laurentflorin/marax-pressure-mod/doc/README.md

# Here you will find more Details about the build

[The UI](ui/ui_overview.md)

[The Hardware](hardware/hardware.md)

[The Build](build/build.md)

[Pressure Profiles](profiles/profiles.md)

[Home Assistant Integration](homeassistant/homeassistant.md)

[Linux upload permissions for the ESP32-S3 board](build/linux-upload-permissions.md)
