laurentflorin/marax-pressure-mod/doc/ui/ui_overview.md

# A overview of the different UI pages

## Home page

The home page displays the brew and steam temperature, further the bluetooth sign shows if the Felicita Arc scale is connected.

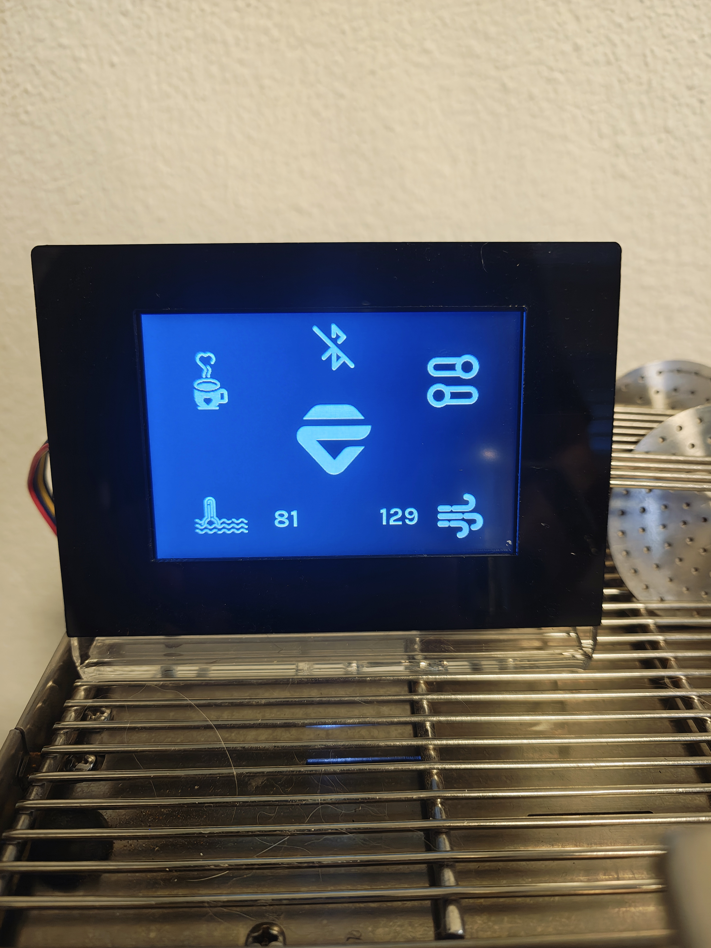
[picture p1: assets/home_scale_not_connected.jpg]
HomePage_no_scale

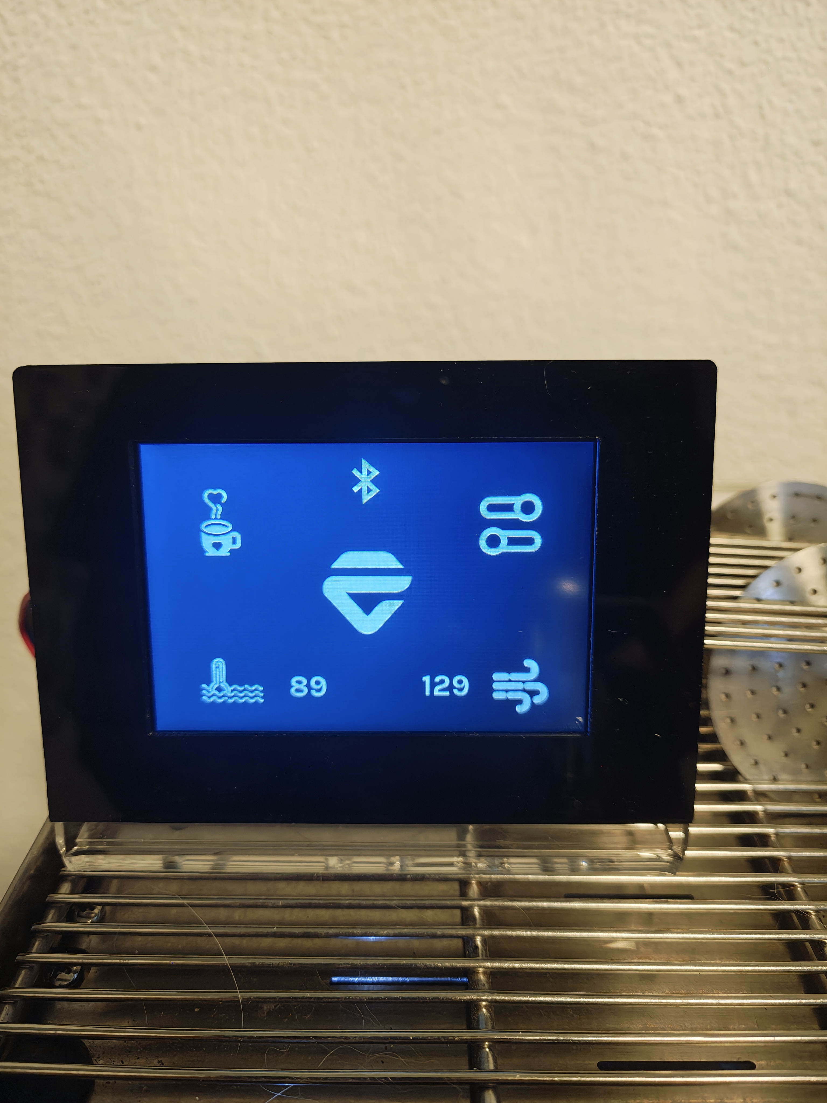
[picture p2: assets/home_scale_connected.jpg]
HomePage_scale


By touching the right top icon the settings page can be reached. By touching the coffe cup icon the brew page is opened.
## Settings Page

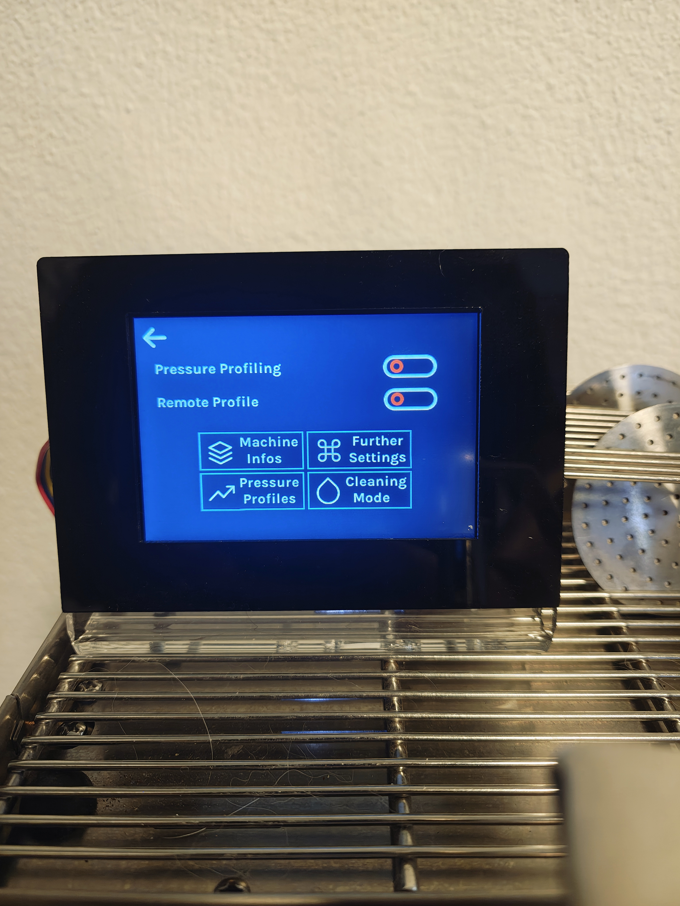
[picture p3: assets/settings.jpg]
Settings


On the settings page the other pages can be reached. As well as the pressure profiling and remote profile can be activated. For the use of preset profiles, both have to be activated.

## Brew graph page

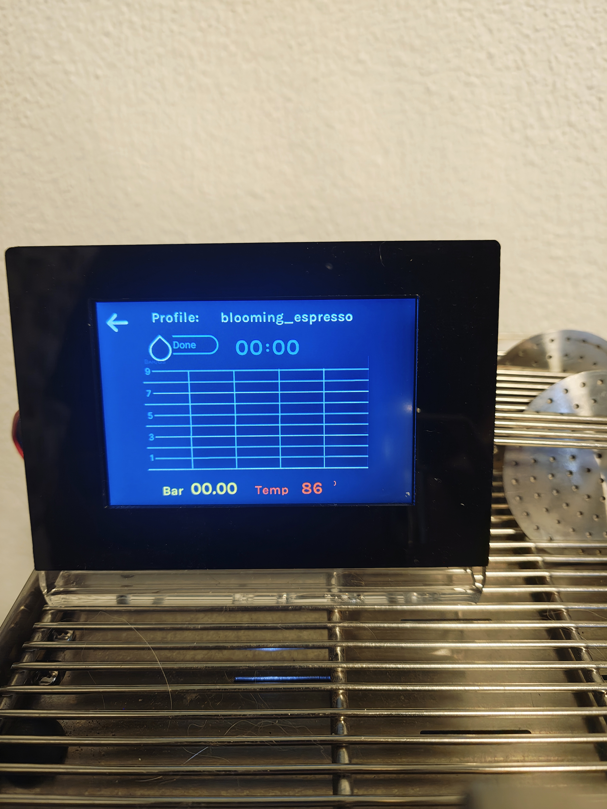
[picture p4: assets/brew_page.jpg]
BrewGraph


The brew graph page will automatically be shown if the brew leaver it switched to the "on/top" postion

## Cleaning Page

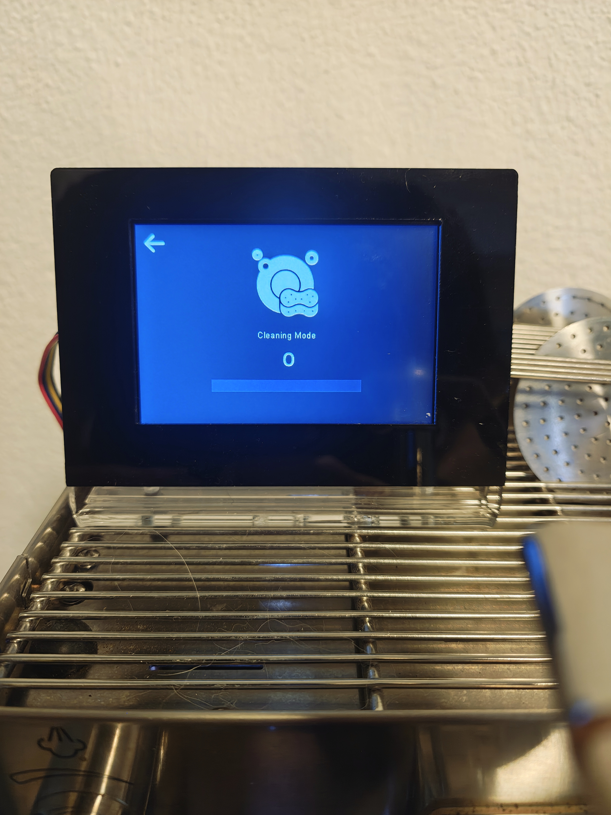
[picture p5: assets/clean_page.jpg]
CleaningPage


If the cleaning page is active, it will count the shot time of the cleaning flush as well as the current amount of flushes that have been done.

## Pressure Profile Selection Page

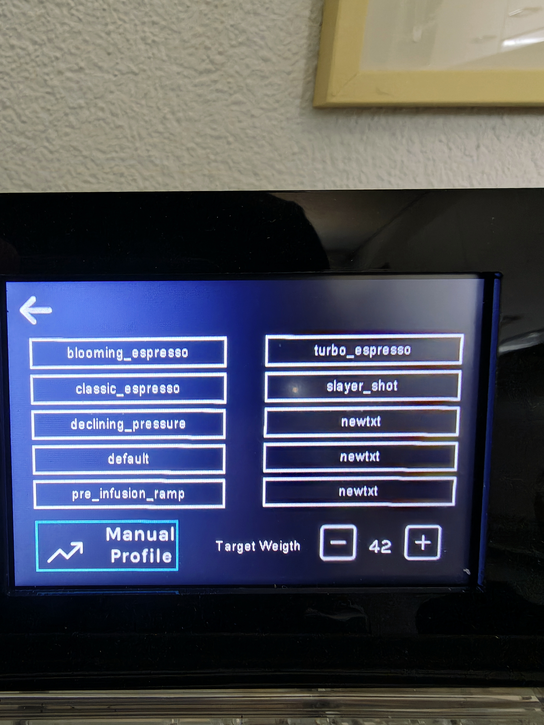
[picture p6: assets/profile_selection.jpg]
PP_Page


On this page the desired preset profile can be chosen as well as the target output weight. 

## Manual Pressure Profile Selection 

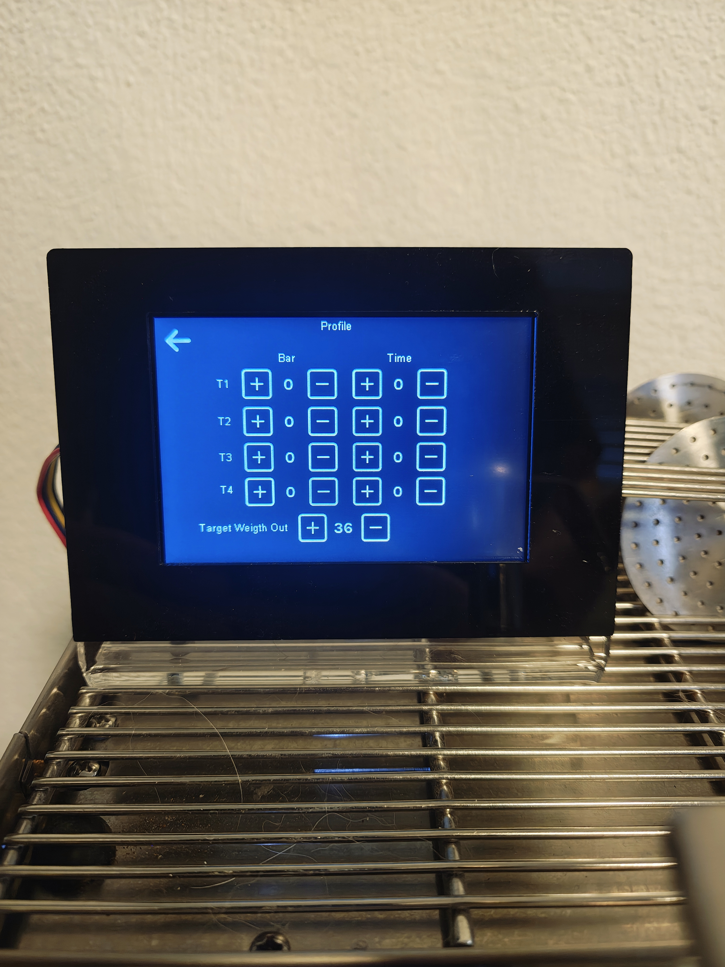
[picture p7: assets/manual_profile.jpg]
PP_Page_manual

Here a manual pressure profile can be set up. To use the manual profile Remote profile has top be switched off.
The Pressure Profile that can be set. There a four time slots which can each have different pressures set.
Example Shot -> 5 Bar for 5 Sec. then 6 Bar for 6 Sec. then 7 Bar for 5 Sec. then 8 Bar for 3 Sec.
