laurentflorin/marax-pressure-mod/doc/hardware/hardware.md

# Hardware List

| Component | Link |
| --- | --- |
| Nextion 3.5 | https://de.aliexpress.com/item/1005003457376097.html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 |
| Pressure Sensor | https://de.aliexpress.com/item/1005007148779919.html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 |
| 240V dimmer | https://de.aliexpress.com/item/32802025086.html?gatewayAdapt=glo2deu |
| Relay | https://de.aliexpress.com/item/1005010569779398.html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 |
| stand for nexiton 3.5 | https://de.aliexpress.com/item/4000024254086.html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 |
| 12V to 5V Dc Dc Stepdown converter | https://de.aliexpress.com/item/1005010036505161.html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 |
| Cable 17 AWG | https://de.aliexpress.com/item/1005011947614719.html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 |
| Cable sleeve | https://de.aliexpress.com/item/1005007570262725.html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 |
| resistor | https://de.aliexpress.com/item/1005011767578775.html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 |
| Arduino nano breakout board | https://de.aliexpress.com/item/1005008228852970.html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 |
| dupont crimping tool | https://de.aliexpress.com/item/1005009408516954.html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 |
| ptfe tube cutter | https://de.aliexpress.com/item/1005006149490949.html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 |
| Standoffs | https://de.aliexpress.com/item/32862529967.html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 |
| Crimp Connectors | https://de.aliexpress.com/item/1005009345066209.html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 |
| SD Card reader | https://www.bastelgarage.ch/micro-sd-card-reader-modul |
| Micro sd Card | https://www.bastelgarage.ch/8gb-microsdhc-memory-card-class-10-uhs-i-incl-sd-adapter?search=micro%20sd%20card |
| ESP32 S3 | [www.bastelgarage.ch/esp32-s3-dev-kit-n16r8-m-entwicklungsboard](https://www.bastelgarage.ch/esp32-s3-dev-kit-n16r8-m-entwicklungsboard) |
| g1/4 Connectors | https://www.hug-technik.com/shop/steckverschraubung-gerade-g-1-4-ig-schlauch-o-5-click-clock.html |
| T Connector | https://www.hug-technik.com/shop/t-steckverbindung-schlauch-o-5-click-clock-messing-vernickelt.html |
| Silicon Tube | https://www.bluestarcoffee.eu/en/Lelit-Ptfe-Teflon-Pipe-3x5mm/m-6151.aspx |
| AWG 24 Cables | https://www.bastelgarage.ch/kabel-16x0-25mm-awg24-grau-liyy?search=kabel |
