laurentflorin/marax-pressure-mod/assets/brew_switch_side.jpg

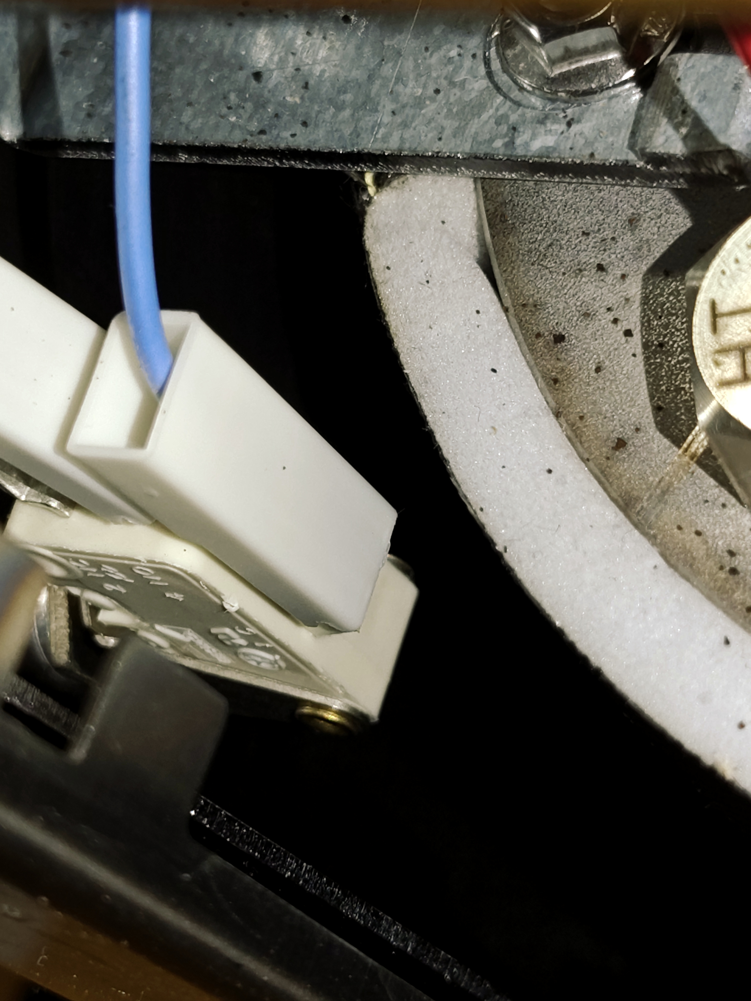
assets/brew_switch_side.jpg
