laurentflorin/marax-pressure-mod/assets/more_info.jpg

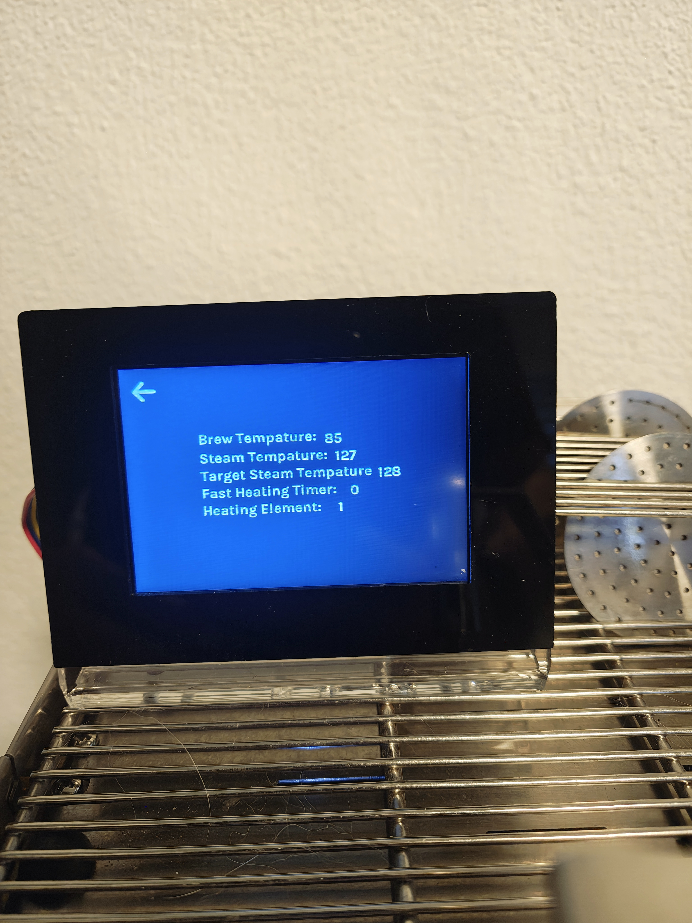
assets/more_info.jpg
