laurentflorin/marax-pressure-mod/assets/more_settings.jpg

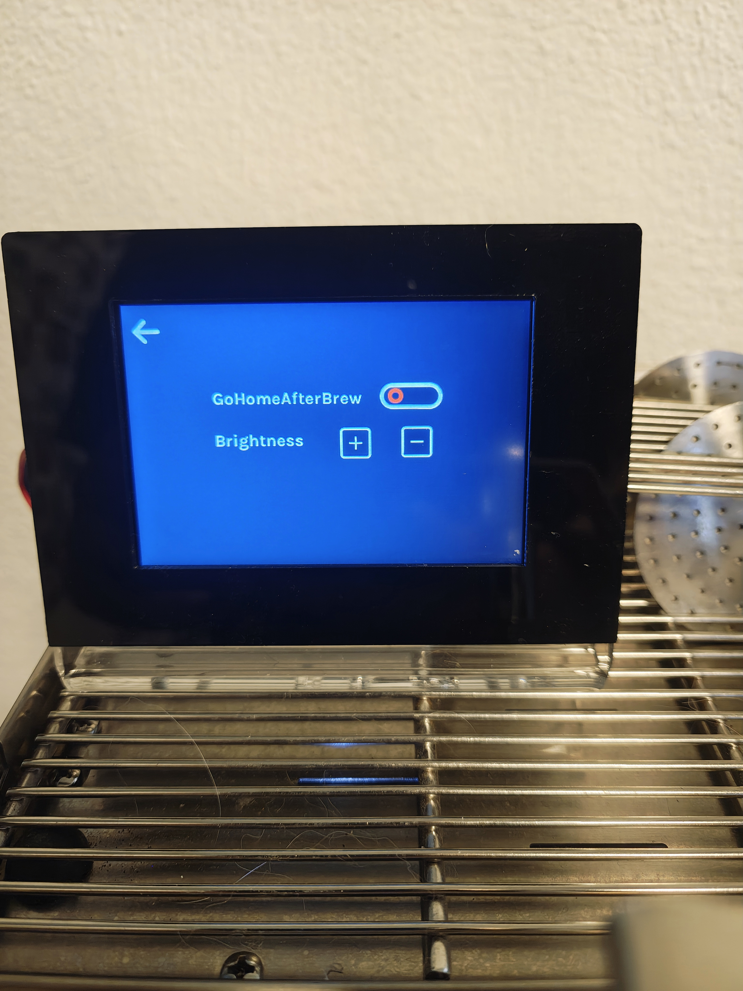
assets/more_settings.jpg
