laurentflorin/marax-pressure-mod/src/marax_esp32s3/marax_esp32s3.ino

#include <Arduino.h>
#include <EasyNextionLibrary.h>

// DISABLE WiFi to prevent radio conflicts with BLE
// ESP32-S3 has only ONE 2.4GHz radio shared between WiFi and BLE
// Disabling WiFi gives BLE full control for reliable scale connection
// #define DISABLE_WIFI_MQTT

// ─────────────────────────────────────────────────────────────────────────
// OTA (Over-The-Air firmware updates over WiFi)
// Comment out ENABLE_OTA to build without OTA.
//
// WARNING: OTA requires WiFi. The ESP32-S3 shares ONE 2.4GHz radio between
// WiFi and BLE, so bringing WiFi up for OTA can reduce BLE scale reliability
// (this is the very reason DISABLE_WIFI_MQTT exists). The OTA code here is
// non-blocking and never stalls normal operation. Set wifi_ssid /
// wifi_password (below) before using OTA.
// Flashing: Arduino IDE → Tools → Port → network port "MaraXController at <ip>".
// ─────────────────────────────────────────────────────────────────────────
#define ENABLE_OTA

#include <WiFi.h>
#include <PubSubClient.h>
#include <SD.h>
#include <SPI.h>
#include <Preferences.h>
#include <driver/uart.h>
#include <NimBLEDevice.h>
#include "FelicitaScale_NimBLE.h"

#ifdef ENABLE_OTA
#include <ESPmDNS.h>
#include <ArduinoOTA.h>
#endif

// === Required Libraries ===
// - EasyNextionLibrary     (Arduino Library Manager)
// - WiFi                   (built-in with ESP32 Arduino core)
// - PubSubClient           (Arduino Library Manager)
// - SD                     (Arduino built-in)
// - NimBLE-Arduino         (Arduino Library Manager) - REQUIRED for ESP32-S3 BLE
// NOTE: ArduinoBLE and AcaiaArduinoBLE are NOT compatible with ESP32-S3!
//       Using NimBLE-based implementation instead (FelicitaScale_NimBLE.h)
//
// Arduino IDE board: "ESP32S3 Dev Module"
//   Board package:   esp32 by Espressif Systems (Boards Manager)
//   Flash size:      16MB (128Mb)
//   PSRAM:           OPI PSRAM
//   USB Mode:        Hardware CDC and JTAG

// ═══════════════════════════════════════════════════════════════════════════
// Board: ESP32-S3-DEV-KIT-N16R8-M (Waveshare)
//
// The Mara X GiCar board outputs INVERTED UART (idle LOW, like RS-232).
// On ESP32-S3 this is fixed in SOFTWARE via uart_set_line_inverse().
// No hardware inverter or transistor required!
//
// IMPORTANT: Physical wiring - ESP32 RX connects to MaraX TX, and vice versa:
//   - ESP32 GPIO16 (RX) ← physically wire to → MaraX TX pin
//   - ESP32 GPIO17 (TX) ← physically wire to → MaraX RX pin
//
// Pin Assignments:
//   GPIO16  ← MaraX TX   (UART1 RX, inverted in software)
//   GPIO17  → MaraX RX   (UART1 TX)
//   GPIO18  ← Nextion TX (UART2 RX)
//   GPIO8   → Nextion RX (UART2 TX)
//   GPIO3   ← Pressure sensor output (ADC1_CH2)
//              IMPORTANT: Must use ADC1 (GPIO1–10). ADC2 (GPIO11–20)
//              cannot be used for analog reads when WiFi is active!
//   GPIO4   ← AC mains zero-cross detection (sync for dimmable_light)
//   GPIO5   → Pump TRIAC gate (via optocoupler)
//   GPIO6   ← Brew lever switch input
//   GPIO7   → GiCar brew relay output
//   GPIO10  → SD card CS
//   GPIO11  → SD card MOSI (SPI2 / FSPI)
//   GPIO12  → SD card SCK
//   GPIO13  ← SD card MISO
//
// Machine Data Format: CSV (field order as parsed by getMaschineInput())
//   Example frame: +1.10,103,128,077,0000,1,0
//   Field 0: Version/Mode (+1.10)
//   Field 1: Steam temperature (103 = 103°C)
//   Field 2: Steam target temperature (128 = 128°C, may be empty)
//   Field 3: Brew temperature (077 = 77°C)
//   Field 4: Fast heat countdown (0000)
//   Field 5: Heating element status (0 = off, 1 = on)
//   Field 6: Unknown
// ═══════════════════════════════════════════════════════════════════════════

#define MARAX_RX_PIN         16
#define MARAX_TX_PIN         17
#define NEXTION_RX_PIN       18
#define NEXTION_TX_PIN        8
#define PRESSURE_SENSOR_PIN   3   // ADC1_CH2 — safe to use with WiFi
#define AC_ZERO_CROSS_PIN     4
#define PUMP_PIN              5
#define BREW_SWITCH_PIN       6
#define BREW_RELAY_PIN        7
#define SD_CS_PIN            10
#define SD_MOSI_PIN          11
#define SD_SCK_PIN           12
#define SD_MISO_PIN          13

// Brew input/relay electrical behavior:
// - BREW_SWITCH_ACTIVE_LOW=1 means GPIO reads LOW when lever is ON (default).
// - BREW_RELAY_ACTIVE_HIGH=1 means GPIO HIGH energizes relay (default).
// If your relay board is low-level-trigger, set BREW_RELAY_ACTIVE_HIGH to 0.
#define BREW_SWITCH_ACTIVE_LOW 1
#define BREW_RELAY_ACTIVE_HIGH 1
#define BREW_SWITCH_DEBOUNCE_MS 35

// nunununununununununununununununununununununununununununununun
// nunununununununununununu Wifi and Bluetooth
// nunununununununununununununununununununununununununununununun
#define wifi_ssid ""
#define wifi_password ""
// Scale MAC address - empty string enables auto-discovery of any Felicita scale
#define SCALE_MAC_ADDRESS ""

WiFiClient wifiClient;
bool wifiConnected = false;
bool scaleConnected = false;

// nunununununununununununununununununununununununununununununun
// nunununununununununununu Timers
// nunununununununununununununununununununununununununununununun
long serialMaraxUpdateMillis = millis();
long updateMqttTimer = millis();
long readSettigsRefreshTimer = millis();
unsigned long pageRefreshTimer = millis();
unsigned long refresh_timer = millis();
unsigned long activeBrewingStart = millis();
unsigned long lastWifiReconnectAttemptMs = 0;
unsigned long lastMqttReconnectAttemptMs = 0;
const unsigned long WIFI_RECONNECT_INTERVAL_MS = 10000;  // Try every 10 seconds
const unsigned long MQTT_RECONNECT_INTERVAL_MS = 5000;   // Try every 5 seconds

bool POWER_ON = false;

// Nextion display on UART2 (Serial2)
// Note: we initialize Serial2 directly in setup() with explicit pins.
// myNex.begin() is intentionally NOT called — doing so would re-init Serial2
// with default pins, overriding our custom NEXTION_RX/TX pin assignment.
EasyNex myNex(Serial2);

// Forward declaration required because PubSubClient constructor references it
void callbackfun(char *topic, byte *payload, unsigned int length);
void showProfileSelection();
void populateProfileList();
void handleProfileSelection(int rowIndex);
bool selectProfile(int profileIndex);
void handleNextionProfileTouchEvents();
void loadPersistedProfileSelection();
void persistSelectedProfile();
void loadPersistedTargetWeight();
void persistTargetWeight();
void updateTargetWeightUi(bool force);
void updateProfileSelectionHighlight();
bool loadProfile(const char *filename);
void updateProfileModeText();
void scanProfiles();
bool readRawBrewSwitchOn();
bool readDebouncedBrewSwitchOn();
void writeBrewRelay(bool brewOn);
void resumeIdleBoilerFill();
void applyManualStepsToProfile();
void publishProfileState();
void processPendingProfileCommand();
void buildProfileCsv(String &out);
float profileTotalSeconds();
float profileTargetPressureAt(float second);
int pressureToWave(float bar);
void writeBrewTimerColour(uint32_t colour);
void writeSetBarValue(int wave);

// nunununununununununununununununununununununununununununununun
// nunununununununununununu MQTT Settings
// nunununununununununununununununununununununununununununununun
#define mqtt_server ""
#define mqtt_user ""
#define mqtt_password ""

#define brewtemp_topic           "marax/sensor/brewtemp"
#define steamtemp_topic          "marax/sensor/steamtemp"
#define steamtargettemp_topic    "marax/sensor/steamtargettemp"
#define fastheat_topic           "marax/sensor/fastheat_timer"
#define heatingElement_topic     "marax/sensor/heatingelement"
#define debug_topic              "marax/sensor/debug"
#define shots_topic              "marax/sensor/shots"
#define power_topic              "marax/sensor/power_state"

// Last-will topic: retained "online" while the ESP32 is connected, flipped to
// "offline" by the broker the moment the connection drops. Every discovered
// entity references it, so Home Assistant greys them out instead of showing a
// stale retained reading when the controller is unplugged or loses WiFi.
#define availability_topic       "marax/status"

// Profile editing. The controller publishes the profile list, the active
// profile's name and its full body; commands arrive on the select/save/delete
// topics and every one of them is answered on the result topic.
//
// The body is the same v2 CSV that lives on the SD card, in both directions.
// Carrying one format end to end means the firmware never has to parse JSON:
// it validates the bytes with the reader it already has and writes them
// straight to the card.
#define profile_list_topic       "marax/profile/list"
#define profile_name_topic       "marax/profile/name"
#define profile_active_topic     "marax/profile/active"
#define profile_result_topic     "marax/profile/result"
#define profile_select_topic     "marax/profile/select"
#define profile_save_prefix      "marax/profile/save/"
#define profile_delete_prefix    "marax/profile/delete/"

// ─────────────────────────────────────────────────────────────────────────
// Home Assistant MQTT discovery
//
// With this enabled the controller publishes retained config payloads under
// homeassistant/<component>/marax/<id>/config on every MQTT (re)connect, and
// Home Assistant creates the entities itself — no YAML needed on the HA side.
// Comment out to keep publishing plain values without announcing them.
// ─────────────────────────────────────────────────────────────────────────
#define ENABLE_HA_DISCOVERY

#define ha_discovery_prefix      "homeassistant"
#define ha_device_id             "marax"

// PubSubClient's default 256-byte buffer would silently drop every payload
// bigger than that (publish() just returns false). The largest traffic here is
// a full profile body and the profile-select discovery payload, which carries
// one option per profile on the card.
#define MQTT_BUFFER_SIZE         2048
// Profile bodies are bounded so an oversized retained payload cannot be
// accepted and then fail to fit in the buffer on the way back out.
#define PROFILE_BODY_MAX_LEN     1024
// The select entity announces the profiles as options. Beyond this the payload
// would not fit the buffer, so the list is cut and the truncation logged
// rather than losing the whole announcement.
#define PROFILE_SELECT_MAX_OPTIONS 40

PubSubClient mqttClient(mqtt_server, 1883, callbackfun, wifiClient);

// nunununununununununununununununununununununununununununununun
// nunununununununununununu CONSTS
// nunununununununununununununununununununununununununununununun
#define REFRESH_SCREEN_EVERY 150 // Screen refresh interval (ms)
// Nextion writes during a brew are throttled to this interval so UART2 traffic
// cannot pace the loop that runs pressure control and the weight cut-off.
#define LIVE_DATA_REFRESH_MS 100

bool brewActive = false;
bool brewTimerActive = false; // active if brewing or descaling

// nunununununununununununununununununununununununununununununun
// nunununununununununununu MaraxSerialStuff
// nunununununununununununununununununununununununununununununun
const byte numCharsSerialMarax = 32;
char receivedCharsFromMarax[numCharsSerialMarax];
static byte ndx = 0;
char endMarker = '\r'; // Mara X terminates frames with CR (\r), not LF (\n)
char rc;

// Serial Marax Sensors
int brewTemp = 0;
int steamTemp = 0;
int steamTargetTemp = 0;
int maraxMode = 0;
int fastHeatingCountDown = 0;
bool heatingElementOn = false;

// nunununununununununununununununununununununununununununununun
// nunununununununununununu Pins
// nunununununununununununununununununununununununununununununun
int brewSwitchRelayPin = BREW_RELAY_PIN;
int brewSwitchPin = BREW_SWITCH_PIN;

int shotCount = 0;

float voltage;
uint32_t barGraphValue;

bool pressureProfilingEnabled = false;
bool remoteProfilingEnabled = false;

bool cleaningModeActive = 0;
bool cleaningRunActive = 0;
int cleaningShots = 0;
int cleaningShotsWater = 0;

bool brewSwitchStableOn = false;
bool brewSwitchLastRawOn = false;
bool brewSwitchDebounceInitialized = false;
unsigned long brewSwitchLastChangeMs = 0;

uint32_t currentPageId = 0;
uint32_t lastPageId = 0;
bool displayIsInSleep = true;

// nunununununununununununununununununununununununununununununun
// nunununununununununununu Pressure Profile
// nunununununununununununununununununununununununununununununun
// A profile is a polyline. Each point anchors a target pressure at an absolute
// time from the start of the shot, and `jump` says how the curve reaches that
// point:
//
//   ramp — interpolate linearly from the previous point
//   jump — hold the previous pressure until this point's time, then step to it
//
// Together they express everything from a classic four-step staircase (every
// point a jump) to a smooth declining curve (every point a ramp), including
// mixtures: hold 3 bar, jump straight to 8, hold, then ramp down to 6.
#define MAX_PROFILE_POINTS 16
#define PROFILE_MAX_BAR 12.0f
#define PROFILE_MAX_SECONDS 600.0f
// Two points is the minimum that describes a span of time; one point has no
// duration and would leave the pump with nothing to follow.
#define PROFILE_MIN_POINTS 2

struct ProfilePoint
{
  float seconds;  // absolute time from the start of the shot
  float bar;      // target pressure at that moment
  bool jump;      // true: step at `seconds`, false: ramp in from the point before
};

ProfilePoint profilePoints[MAX_PROFILE_POINTS];
int profilePointCount = 0;

// Parsed from the profile file and preserved when it is written back, but
// deliberately NOT applied to the running `targetWeight` — the brew-by-weight
// target comes from the display and Preferences, and always has. Keeping the
// field intact means hand-edited files do not lose it on a round trip.
float profileTargetWeightField = 0.0f;

// Manual mode only: the display's four fixed step fields. The Nextion firmware
// has physical t1p…t4t inputs, so manual editing stays four steps; they are
// converted into profilePoints[] by applyManualStepsToProfile().
int t1p = 0, t1t = 0, t2p = 0, t2t = 0, t3p = 0, t3t = 0, t4p = 0, t4t = 0;

// SD / Profile globals
#define MAX_PROFILES 64
#define PROFILE_NAME_MAX_LEN 32
#define MAX_PATH_LEN 64
#define PROFILE_FIELD_COUNT 10
#define PROFILE_CSV_BUFFER_LEN 128
#define PROFILE_ROWS_PER_PAGE 10
#define PROFILE_TOUCH_COMPONENT_ID_MIN 5
#define PROFILE_TOUCH_COMPONENT_ID_MAX 14
// Fallback page ID for `profile1` (matches page order in MaraxDisplayFile.HMI).
#define PROFILE_PAGE_ID_FALLBACK 4
// How long readNextionNumber() waits for a `get` reply before giving up. The
// display answers in well under a millisecond at 115200 baud, so this is
// generous; it only elapses when the display is busy, unplugged, or asked for
// something that does not exist. Keep it well below the display refresh
// interval so a dead read cannot stall the loop.
#define NEXTION_READ_TIMEOUT_MS 150
// Depth of the touch-event queue drained by handleNextionProfileTouchEvents().
#define NEXTION_TOUCH_QUEUE_LEN 8
// Row colours on the profile selection page (RGB565).
#define PROFILE_ROW_PCO          65535  // white text
#define PROFILE_ROW_BCO           8518  // dark slate background
#define PROFILE_ROW_PCO_SELECTED  2016  // green text
#define PROFILE_ROW_BCO_SELECTED 17036  // lighter slate background
// Brew page graph, as defined in display/MaraxDisplayFile.HMI: the waveform
// `s0` has object id 1, is 350 x 180 px with dis=100, and has two channels —
// channel 0 carries the measured pressure, channel 1 the target. One sample
// per x pixel, value 0..180 spanning 0..10 bar.
#define BREW_PAGE_ID 2
#define BREW_WAVEFORM_ID 1
#define BREW_WAVEFORM_TARGET_CHANNEL 1
#define BREW_WAVEFORM_WIDTH 350
#define BREW_WAVEFORM_HEIGHT 180
// Handshake timeouts for `addt` (transparent data mode): the display answers
// 0xFE when it is ready for the raw bytes and 0xFD once it has taken them all.
#define NEXTION_ADDT_READY_TIMEOUT_MS 200
#define NEXTION_ADDT_DONE_TIMEOUT_MS 500
// Bounds for manual-mode values read back from the display. Anything outside
// these ranges is a garbled read.
#define MANUAL_PRESSURE_MAX_BAR 12
#define MANUAL_SEGMENT_MAX_SECONDS 600
#define WEIGHT_STABLE_WINDOW_MS 2000  // how long weight must be stable before committing observation
#define WEIGHT_STABLE_THRESHOLD 0.5f  // max increase (g) over stability window
#define OBSERVATION_MAX_WAIT_MS 5000 // max time to wait for stability after brew stop
char activeProfileName[PROFILE_NAME_MAX_LEN] = "default";
char activeProfileFileStem[PROFILE_NAME_MAX_LEN] = "default";
char profileNames[MAX_PROFILES][PROFILE_NAME_MAX_LEN];
int profileCount = 0;
String profileListStr = "";
int selectedProfileIndex = 0;
int profileListPageStart = 0;
int profileSelectionPageId = PROFILE_PAGE_ID_FALLBACK;
bool profilePageNeedsPopulate = true;
// Set when the brew page's target-curve preview has to be (re)drawn: on
// entering the page, and when the loaded profile changes while it is open.
bool brewPreviewNeedsDraw = false;
uint32_t lastPreviewSignature = 0;
unsigned long lastProfileScanMs = 0;
const unsigned long PROFILE_SCAN_INTERVAL_MS = 30000;
float targetWeight = 36.0f;
bool sdReady = false;
char persistedProfileFile[PROFILE_NAME_MAX_LEN] = "";
Preferences preferences;

// Kept here rather than up with the other MQTT globals because the struct
// sizes its members with PROFILE_NAME_MAX_LEN, defined just above.
// MQTT commands are recorded by the callback and carried out later from the
// main loop. The callback runs inside mqttClient.loop(); writing to the SD card
// or publishing from in there would re-enter the client and stall the loop at
// an arbitrary moment — including in the middle of a shot.
enum ProfileCommandKind
{
  PROFILE_CMD_NONE = 0,
  PROFILE_CMD_SELECT,
  PROFILE_CMD_SAVE,
  PROFILE_CMD_DELETE,
  PROFILE_CMD_TOO_LARGE  // recorded so the sender gets an answer either way
};

struct PendingProfileCommand
{
  ProfileCommandKind kind;
  char stem[PROFILE_NAME_MAX_LEN];
  char body[PROFILE_BODY_MAX_LEN];
  unsigned int bodyLength;
};

PendingProfileCommand pendingProfileCommand = { PROFILE_CMD_NONE, "", "", 0 };
// Set whenever the profile list or the active profile changes, so the retained
// topics are refreshed from the main loop rather than from wherever the change
// happened to occur.
bool profileStateDirty = true;

// Touch events arriving on UART2 are queued by nextionProcessRx() instead of
// being acted on where they are parsed, so a `get` reply can never swallow one.
struct NextionTouchEvent
{
  uint8_t pageId;
  uint8_t componentId;
  uint8_t eventType;
};
NextionTouchEvent nextionTouchQueue[NEXTION_TOUCH_QUEUE_LEN];
uint8_t nextionTouchQueueHead = 0;
uint8_t nextionTouchQueueCount = 0;

FelicitaScale_NimBLE scale(false);  // true = enable debug to see BLE scan results
float currentWeight = 0.0f;
float prevWeight = 0.0f;
unsigned long lastWeightTime = 0;
float flowRate = 0.0f;
int lastScaleConnectedUi = -1; // -1 forces first UI update
unsigned long lastScaleReconnectAttemptMs = 0;
const unsigned long SCALE_RECONNECT_INTERVAL_MS = 30000;  // 30 seconds between scan attempts

bool pendingObservation = false;
unsigned long pendingObsTime = 0;
float pendingFlowAtStop = 0.0f;
float pendingPressAtStop = 0.0f;
float pendingWeightAtStop = 0.0f;
float pendingStabilityCheckWeight = 0.0f;
unsigned long pendingStabilityCheckTime = 0;
int pendingBrewTimeS = 0;

// nunununununununununununununununununununununununununununununun
// nunununununununununununu LowPassFilterStuff
// nunununununununununununununununununununununununununununununun
const float alpha = 0.97; // Low Pass Filter alpha (0 - 1)
float filteredVal = 2048.0; // midpoint of 12-bit ADC (0–4095)
float sensorVal;

// nunununununununununununununununununununununununununununununun
// nunununununununununununu AC Dimming (Zero-Cross Phase Control)
// nunununununununununununununununununununununununununununununun
//
// NOTE: No dedicated AC dimmer library is used here because the available
// libraries (RBDdimmer, dimmable-light-arduino) conflict with ESP32-S3's
// hardware timer API changes in Arduino core v3.x.  The hand-rolled
// zero-cross + one-shot timer approach below is equivalent and confirmed
// to compile on ESP32-S3 core 3.x.
//
// How it works:
//   1. zeroCrossISR fires on every AC zero-crossing (100 times/sec at 50 Hz).
//   2. It starts a one-shot hardware timer whose period is calculated from
//      pumpBrightness: high brightness → short delay → TRIAC fires early in
//      the half-cycle → more power delivered.
//   3. triacTriggerISR fires when the timer expires and pulses the TRIAC gate.
//
// Brightness mapping (pumpBrightness 0–255):
//   0   → pump OFF  (ISR returns immediately, no TRIAC trigger)
//   255 → FULL power (TRIAC triggered immediately at zero-cross)
//   1–254 → delay = map(brightness, 0, 255, 10000µs, 100µs)
//            i.e. brightness=128 → ~5050µs delay → ~50% power
//
// Idle pressure threshold above which the boiler is considered full.
// It switches dynamically: 5.0 bar when steam is hot (>80°C), otherwise 0.5 bar.
float boilerFullPressureBar = 0.5f;

// Dimmer debug counters (global so brewDetect can seed them at brew start)
unsigned long lastDimmerDebugMs = 0;
uint32_t lastZeroCrossCountDebug = 0;
// Latch: once pressure cuts the pump in idle, stay off until next brew ends
bool boilerFullLatch = false;
// Latch: once the weight reaches target minus the pressure-dependent offset
// during a profiled brew, keep the pump off until the brew ends (lever released)
bool targetWeightReached = false;
volatile uint8_t  pumpBrightness = 255;  // 0-255, 255 = full power (no dimming)
volatile uint32_t zeroCrossCount = 0;    // Incremented in ISR, read in debug
hw_timer_t *acTimer = NULL;
portMUX_TYPE acTimerMux = portMUX_INITIALIZER_UNLOCKED;

void IRAM_ATTR zeroCrossISR() {
  zeroCrossCount++;  // Count every half-cycle (debug: expect 100/s at 50 Hz)

  // Zero-cross detected — start timer for TRIAC trigger delay
  if (pumpBrightness == 0) {
    return;  // Off, don't trigger
  }
  
  if (pumpBrightness == 255) {
    // Full power - trigger immediately with a pulse
    digitalWrite(PUMP_PIN, HIGH);
    delayMicroseconds(100);  // 100µs gate pulse — matches triacTriggerISR
    digitalWrite(PUMP_PIN, LOW);
    return;
  }
  
  // Calculate delay: 0 = ~10ms (full), 255 = ~0μs (off for AC dimming logic)
  // Switzerland: 50Hz AC mains → half-cycle = 10000μs
  uint32_t delayUs = map(pumpBrightness, 0, 255, 10000, 100);
  
  portENTER_CRITICAL_ISR(&acTimerMux);
  timerRestart(acTimer);
  timerAlarm(acTimer, delayUs, false, 0);  // One-shot timer
  portEXIT_CRITICAL_ISR(&acTimerMux);
}

void IRAM_ATTR triacTriggerISR() {
  digitalWrite(PUMP_PIN, HIGH);  // Trigger TRIAC
  delayMicroseconds(100);        // 100µs pulse — minimum for reliable MOC3021/BT136 triggering
  digitalWrite(PUMP_PIN, LOW);
}

void setPumpBrightness(uint8_t brightness) {
  portENTER_CRITICAL(&acTimerMux);
  uint8_t prev = pumpBrightness;
  pumpBrightness = brightness;
  portEXIT_CRITICAL(&acTimerMux);

  // Log every change so we can trace what is sent to the dimmer
  if (brightness != prev) {
    uint32_t delayUs = 0;
    if (brightness > 0 && brightness < 255)
      delayUs = map(brightness, 0, 255, 10000, 100);

    Serial.print("[DIMMER] ");
    Serial.print(prev); Serial.print(" → "); Serial.print(brightness);
    Serial.print("/255  (");
    Serial.print(brightness * 100 / 255);
    Serial.print("%)");
    if (brightness == 0)        Serial.print("  → PUMP OFF (no TRIAC trigger)");
    else if (brightness == 255) Serial.print("  → FULL POWER (immediate trigger)");
    else { Serial.print("  → TRIAC delay "); Serial.print(delayUs); Serial.print("µs"); }
    Serial.println();
  }
}

void resumeIdleBoilerFill()
{
  boilerFullLatch = false;
  setPumpBrightness(255);
}

void primePressureFilter()
{
  sensorVal = (float)analogRead(PRESSURE_SENSOR_PIN);
  filteredVal = sensorVal;
  voltage = (filteredVal / 4096.0f) * 3.3f;
}

// nunununununununununununununununununununununununununununununun
// nunununununununununununu OTA (Over-The-Air Updates)
// nunununununununununununununununununununununununununununununun
#ifdef ENABLE_OTA
// OTA needs WiFi. In this build WiFi may otherwise be disabled for BLE, so the
// helpers below bring WiFi up themselves (non-blocking) and start the OTA
// service lazily once an IP is obtained. Normal operation never blocks on OTA.
bool otaInitialized = false;
unsigned long lastOtaWifiAttemptMs = 0;
const unsigned long OTA_WIFI_RETRY_INTERVAL_MS = 10000;  // background reconnect cadence

void setupOTA()
{
#ifdef DISABLE_WIFI_MQTT
  // WiFi is not started anywhere else in this build — OTA must bring it up.
  WiFi.mode(WIFI_STA);
  WiFi.setHostname("MaraXController");
  WiFi.begin(wifi_ssid, wifi_password);
  lastOtaWifiAttemptMs = millis();
#endif

  ArduinoOTA.setHostname("MaraXController");
  // Optional: require a password to push updates (recommended on shared networks).
  // ArduinoOTA.setPassword("admin");

  ArduinoOTA
    .onStart([]() {
      // Safety: kill the pump before the device reboots into new firmware.
      setPumpBrightness(0);
      String type = (ArduinoOTA.getCommand() == U_FLASH) ? "sketch" : "filesystem";
      Serial.println("[OTA] Start updating " + type);
    })
    .onEnd([]() {
      Serial.println("\n[OTA] End");
    })
    .onProgress([](unsigned int progress, unsigned int total) {
      static unsigned long lastOtaProgressMs = 0;
      if (total > 0 && millis() - lastOtaProgressMs > 500) {
        Serial.printf("[OTA] Progress: %u%%\n", (progress / (total / 100)));
        lastOtaProgressMs = millis();
      }
    })
    .onError([](ota_error_t error) {
      Serial.printf("[OTA] Error[%u]: ", error);
      if (error == OTA_AUTH_ERROR)         Serial.println("Auth Failed");
      else if (error == OTA_BEGIN_ERROR)   Serial.println("Begin Failed");
      else if (error == OTA_CONNECT_ERROR) Serial.println("Connect Failed");
      else if (error == OTA_RECEIVE_ERROR) Serial.println("Receive Failed");
      else if (error == OTA_END_ERROR)     Serial.println("End Failed");
    });

  Serial.println("[OTA] Configured — waiting for WiFi to start the service");
}

void handleOTA()
{
  if (WiFi.status() == WL_CONNECTED)
  {
    if (!otaInitialized)
    {
      ArduinoOTA.begin();
      otaInitialized = true;
      Serial.print("[OTA] Ready — hostname MaraXController, IP: ");
      Serial.println(WiFi.localIP());
    }
    ArduinoOTA.handle();
  }
  else
  {
    otaInitialized = false;  // re-announce the service after a reconnect
#ifdef DISABLE_WIFI_MQTT
    // Only OTA manages WiFi in this build, so retry the connection here.
    // (When MQTT is enabled, tryReconnectWifi() owns reconnection instead.)
    unsigned long now = millis();
    if (now - lastOtaWifiAttemptMs >= OTA_WIFI_RETRY_INTERVAL_MS)
    {
      lastOtaWifiAttemptMs = now;
      WiFi.begin(wifi_ssid, wifi_password);
    }
#endif
  }
}
#endif  // ENABLE_OTA

// nunununununununununununununununununununununununununununununun
// nunununununununununununu Setup
// nunununununununununununununununununununununununununununununun
void setup()
{
  // Force the GiCar brew input inactive as soon as the sketch starts.
  // Preloading the output level before switching to OUTPUT avoids a boot
  // pulse while the pin changes modes.
  writeBrewRelay(false);
  pinMode(BREW_RELAY_PIN, OUTPUT);
  writeBrewRelay(false);

  // USB Serial for debugging — open Serial Monitor at 9600
  Serial.begin(9600);
  delay(1000);
  Serial.println("[DEBUG] setup() start");

  // ESP32-S3 ADC is 12-bit (0–4095). Must set this before any analogRead().
  analogReadResolution(12);
  primePressureFilter();

  // AC Dimming: Zero-cross interrupt and TRIAC control
  pinMode(PUMP_PIN, OUTPUT);
  digitalWrite(PUMP_PIN, LOW);
  pinMode(AC_ZERO_CROSS_PIN, INPUT);
  
  // Timer for TRIAC trigger delay
  acTimer = timerBegin(1000000);  // 1MHz (1μs resolution)
  timerAttachInterrupt(acTimer, &triacTriggerISR);
  
  // Zero-cross interrupt — try CHANGE if RISING gives ~75 ZC/s instead of ~100
  attachInterrupt(digitalPinToInterrupt(AC_ZERO_CROSS_PIN), zeroCrossISR, CHANGE);
  
  // Match the post-brew refill behavior on cold boot: give the GiCar full
  // pump authority until idle pressure says the boiler is full.
  resumeIdleBoilerFill();

  pinMode(BREW_SWITCH_PIN, INPUT_PULLUP);

  // Prime lever debounce with current hardware level so first brew transition
  // is edge-driven and not sensitive to switch contact bounce at startup.
  brewSwitchStableOn = readRawBrewSwitchOn();
  brewSwitchLastRawOn = brewSwitchStableOn;
  brewSwitchDebounceInitialized = true;
  brewSwitchLastChangeMs = millis();
  Serial.print("[BREW] Switch polarity: ");
  Serial.println(BREW_SWITCH_ACTIVE_LOW ? "LOW=ON" : "HIGH=ON");
  Serial.print("[BREW] Relay polarity: ");
  Serial.println(BREW_RELAY_ACTIVE_HIGH ? "HIGH=ON" : "LOW=ON");

  // Initialize SPI bus with custom pins for the SD card
  SPI.begin(SD_SCK_PIN, SD_MISO_PIN, SD_MOSI_PIN, SD_CS_PIN);

  delay(200);

  // ═══════════════════════════════════════════════════════════════════════════
  // MaraX UART: 9600 baud, software RX inversion.
  // uart_set_line_inverse() tells the ESP32-S3 hardware UART to treat the
  // idle-LOW (inverted) signal from the GiCar board as normal UART.
  // Must be called AFTER Serial1.begin().
  // ═══════════════════════════════════════════════════════════════════════════
  Serial1.begin(9600, SERIAL_8N1, MARAX_RX_PIN, MARAX_TX_PIN);
  Serial.print("[DEBUG] Serial1 init - RX:GPIO"); Serial.print(MARAX_RX_PIN);
  Serial.print(" TX:GPIO"); Serial.println(MARAX_TX_PIN);
  
  uart_set_line_inverse(UART_NUM_1, UART_SIGNAL_RXD_INV);
  Serial.println("[DEBUG] UART RX inversion enabled");
  
  // Test if UART can read anything
  delay(100);
  int availBytes = Serial1.available();
  Serial.print("[DEBUG] Initial Serial1.available(): "); Serial.println(availBytes);

  // Nextion display on UART2 with explicit pin assignment.
  // The HMI file shipped in this repo is configured for 115200 baud, so
  // UART2 must use the same rate here or the display will ignore writes.
  // We initialize Serial2 directly instead of calling myNex.begin(),
  // because myNex.begin() would call Serial2.begin(baud) without pin
  // arguments and overwrite our custom pin assignment.
  // The default 256-byte RX buffer overflows when the display sends a burst
  // (touch events plus `get` replies) while the loop is busy with SD or BLE
  // work, and a truncated packet desynchronises the parser.
  Serial2.setRxBufferSize(1024);
  Serial2.begin(115200, SERIAL_8N1, NEXTION_RX_PIN, NEXTION_TX_PIN);
  Serial.println("[DEBUG] Serial2 (Nextion) started at 115200");

  // Nextion's default bkcmd=2 returns a 4-byte error packet for every command
  // that fails — which includes every write to a component that is not on the
  // page currently loaded, something updateDisplay() does on each refresh.
  // That junk used to pile up in front of the 0x65 touch events. bkcmd=0
  // silences it; data returns (0x70/0x71 for `get`) are not affected.
  sendNextionCommand("bkcmd=0");

  // Force a known value onto the display right now to verify display wiring
  Serial.println("[DEBUG] Testing Nextion display - writing BOOT to t0.txt");
  myNex.writeStr("t0.txt", "BOOT");
  delay(100);
  
  // Check if display responds by reading connect message
  while (Serial2.available())
  {
    Serial.print("[DEBUG] Nextion response: 0x");
    Serial.println(Serial2.read(), HEX);
  }
  
  delay(2000);

  // Re-send bkcmd: the display shares the power rail with the ESP32, so the
  // first attempt above may have been sent before it finished booting.
  sendNextionCommand("bkcmd=0");

  Serial1.write(0x11);
  Serial.println("[DEBUG] Sent 0x11 wakeup to machine");

  preferences.begin("marax", false);
  loadPersistedProfileSelection();
  loadPersistedTargetWeight();

  // Serial Marax
  memset(receivedCharsFromMarax, 0, numCharsSerialMarax);

  // IMPORTANT: Initialize BLE scale BEFORE WiFi to avoid conflicts
  // BLE and WiFi share radio resources on ESP32, init BLE first
  Serial.println("[DEBUG] Initializing BLE hardware (NimBLE)...");
  
  if (strlen(SCALE_MAC_ADDRESS) > 0)
  {
    Serial.print("[DEBUG] Connecting to scale MAC: ");
    Serial.println(SCALE_MAC_ADDRESS);
  }
  else
  {
    Serial.println("[DEBUG] Auto-discovering any Felicita/Acaia scale...");
  }
  
  // Start scale discovery BEFORE WiFi so BLE gets the best radio conditions,
  // but keep the scan in the background so brew handling is never blocked.
  scale.beginConnect(SCALE_MAC_ADDRESS);
  scaleConnected = scale.isConnected();
  Serial.println(scaleConnected ? "[DEBUG] Scale connected" : "[DEBUG] Scale scan started in background");
  updateScaleConnectionUi();
  lastScaleReconnectAttemptMs = millis();

#ifndef DISABLE_WIFI_MQTT
  if (!mqttClient.setBufferSize(MQTT_BUFFER_SIZE))
  {
    Serial.println("[MQTT] setBufferSize failed — discovery payloads will not fit");
  }

  // WiFi — non-blocking, continue even if connection fails
  Serial.println("[DEBUG] Starting WiFi...");
  WiFi.setHostname("MaraXController");
  WiFi.begin(wifi_ssid, wifi_password);
  unsigned long wifiStartTime = millis();
  while (WiFi.status() != WL_CONNECTED && (millis() - wifiStartTime < 10000))
  {
    delay(500);
  }
  wifiConnected = (WiFi.status() == WL_CONNECTED);
  if (wifiConnected)
  {
    Serial.print("[DEBUG] WiFi connected - IP: ");
    Serial.println(WiFi.localIP());
  }
  else
  {
    Serial.println("[DEBUG] WiFi connection failed");
  }
  lastWifiReconnectAttemptMs = millis();
#else
  Serial.println("[DEBUG] WiFi/MQTT disabled for testing");
#endif

#ifdef ENABLE_OTA
  setupOTA();
#endif

  // SD card init
  Serial.print("[SD] Mounting SD card on CS=GPIO"); Serial.println(SD_CS_PIN);
  if (SD.begin(SD_CS_PIN))
  {
    sdReady = true;
    Serial.print("[SD] Mounted OK — card type: "); Serial.print(SD.cardType());
    Serial.print("  size: "); Serial.print(SD.totalBytes() / (1024 * 1024)); Serial.println(" MB");

    if (!SD.exists("/profiles"))
      SD.mkdir("/profiles");
    if (!SD.exists("/logs"))
      SD.mkdir("/logs");

    if (!SD.exists("/logs/brews.csv"))
    {
      File f = SD.open("/logs/brews.csv", FILE_WRITE);
      if (f)
      {
        f.println("timestamp_ms,profile,actual_weight,target_weight,brew_time_s,flow_rate_at_stop,pressure_at_stop,extra_weight");
        f.close();
      }
    }

    scanProfiles();
    lastProfileScanMs = millis();

    if (profileCount > 0)
    {
      int startupIndex = 0;
      if (persistedProfileFile[0] != '\0')
      {
        for (int i = 0; i < profileCount; i++)
        {
          if (strcmp(profileNames[i], persistedProfileFile) == 0)
          {
            startupIndex = i;
            break;
          }
        }
      }
      selectProfile(startupIndex);
    }

    pressureProfilingEnabled = true;
    remoteProfilingEnabled = true;
    myNex.writeNum("pPEnabled", 1);
    myNex.writeNum("remoteEnabled", 1);

    Serial.print("[DEBUG] Setting up profiles - count:"); Serial.println(profileCount);
    Serial.print("[DEBUG] Profile list string: "); Serial.println(profileListStr);
    Serial.print("[DEBUG] Active profile: "); Serial.println(activeProfileName);
    
    // NOTE: profileList.txt and actProftxt.txt components must exist in HMI
    myNex.writeStr("profileList.txt", profileListStr.c_str());
    Serial.println("[DEBUG] Sent profileList.txt");
    
    myNex.writeStr("actProfile.txt", activeProfileName);
    Serial.println("[DEBUG] Sent actProfiletxt.txt");
    updateTargetWeightUi(true);
    Serial.print("[DEBUG] Restored targetWeight: "); Serial.println((int)targetWeight);
    
    populateProfileList();
    updateProfileModeText();
  }
  else
  {
    Serial.println("[SD] FAILED to mount SD card — check wiring and card format (FAT32)");
    Serial.print("[SD]   CS=GPIO"); Serial.print(SD_CS_PIN);
    Serial.print("  SCK=GPIO"); Serial.print(SD_SCK_PIN);
    Serial.print("  MOSI=GPIO"); Serial.print(SD_MOSI_PIN);
    Serial.print("  MISO=GPIO"); Serial.println(SD_MISO_PIN);
  }

  Serial.println("[DEBUG] setup() complete");
}

// nunununununununununununununununununununununununununununununun
// nunununununununununununu Main Loop
// nunununununununununununununununununununununununununununununun
void loop()
{
  updateScale();
#ifndef DISABLE_WIFI_MQTT
  tryReconnectWifi();
  tryReconnectMqtt();
  if (mqttClient.connected())
  {
    mqttClient.loop();
  }
#endif
#ifdef ENABLE_OTA
  handleOTA();  // Non-blocking: services OTA and (re)connects WiFi in background
#endif
  checkPendingObservation();
#ifndef DISABLE_WIFI_MQTT
  processPendingProfileCommand();
#endif

  handleNextionProfileTouchEvents();

  getMaschineInput();
  updateDisplay();
  updateMqtt();
  brewDetect();
  updateIdlePumpControl();  // Cut dimmer when boiler is full, restore when empty

  liveData();
  pressureProfile();
  tryReconnectScale();

  refresh_timer = millis();
}

void callbackfun(char *topic, byte *payload, unsigned int length)
{
#ifdef DISABLE_WIFI_MQTT
  (void)topic; (void)payload; (void)length;
#else
  if (topic == NULL)
  {
    return;
  }

  // One command at a time. Dropping the newer one is the safe choice: the
  // alternative is a queue that can fill up mid-shot.
  if (pendingProfileCommand.kind != PROFILE_CMD_NONE)
  {
    Serial.println("[MQTT] Profile command dropped — one is already pending");
    return;
  }

  ProfileCommandKind kind = PROFILE_CMD_NONE;
  const char *stem = NULL;

  if (strcmp(topic, profile_select_topic) == 0)
  {
    kind = PROFILE_CMD_SELECT;
  }
  else if (strncmp(topic, profile_save_prefix, strlen(profile_save_prefix)) == 0)
  {
    kind = PROFILE_CMD_SAVE;
    stem = topic + strlen(profile_save_prefix);
  }
  else if (strncmp(topic, profile_delete_prefix, strlen(profile_delete_prefix)) == 0)
  {
    kind = PROFILE_CMD_DELETE;
    stem = topic + strlen(profile_delete_prefix);
  }
  else
  {
    return;
  }

  if (length >= sizeof(pendingProfileCommand.body))
  {
    pendingProfileCommand.kind = PROFILE_CMD_TOO_LARGE;
    pendingProfileCommand.bodyLength = 0;
    pendingProfileCommand.body[0] = '\0';
    pendingProfileCommand.stem[0] = '\0';
    return;
  }

  pendingProfileCommand.stem[0] = '\0';
  if (stem != NULL)
  {
    strncpy(pendingProfileCommand.stem, stem, sizeof(pendingProfileCommand.stem) - 1);
    pendingProfileCommand.stem[sizeof(pendingProfileCommand.stem) - 1] = '\0';
  }

  memcpy(pendingProfileCommand.body, payload, length);
  pendingProfileCommand.body[length] = '\0';
  pendingProfileCommand.bodyLength = length;
  // Written last: the main loop reads `kind` to decide whether the rest of the
  // struct is populated.
  pendingProfileCommand.kind = kind;
#endif
}

void updateMqtt()
{
#ifndef DISABLE_WIFI_MQTT
  // Profile changes are published as they happen rather than on the 5-second
  // tick, so the editor sees its own save land immediately.
  if (profileStateDirty && mqttClient.connected() && !brewActive)
  {
    publishProfileState();
    profileStateDirty = false;
  }

  if ((millis() - updateMqttTimer > 5000) && !brewActive && POWER_ON)
  {
    mqttClient.publish(debug_topic, toCharArray(String(receivedCharsFromMarax)), true);
    mqttClient.publish(brewtemp_topic, toCharArray(String(brewTemp)), true);
    mqttClient.publish(steamtemp_topic, toCharArray(String(steamTemp)), true);
    mqttClient.publish(steamtargettemp_topic, toCharArray(String(steamTargetTemp)), true);
    mqttClient.publish(fastheat_topic, toCharArray(String(fastHeatingCountDown)), true);
    mqttClient.publish(heatingElement_topic, toCharArray(String(heatingElementOn)), true);
    mqttClient.publish(shots_topic, toCharArray(String(shotCount)), true);
    mqttClient.publish(power_topic, toCharArray(String(POWER_ON)), true);

    updateMqttTimer = millis();
  }
#endif
}

const char *toCharArray(const String &str)
{
  return str.c_str();
}

void sendNextionCommand(const String &command)
{
  Serial2.print(command);
  Serial2.write(0xFF);
  Serial2.write(0xFF);
  Serial2.write(0xFF);
}

String nextionEscapedText(const char *raw)
{
  String escaped = "";
  for (int i = 0; raw[i] != '\0'; i++)
  {
    char c = raw[i];
    if (c == '"')
    {
      escaped += '\'';
    }
    else
    {
      escaped += c;
    }
  }
  return escaped;
}

void loadPersistedProfileSelection()
{
  persistedProfileFile[0] = '\0';
  String savedFile = preferences.getString("selected_file", "");
  if (savedFile.length() > 0)
  {
    savedFile.toCharArray(persistedProfileFile, sizeof(persistedProfileFile));
    persistedProfileFile[sizeof(persistedProfileFile) - 1] = '\0';
  }
}

void persistSelectedProfile()
{
  if (selectedProfileIndex < 0 || selectedProfileIndex >= profileCount)
  {
    return;
  }
  preferences.putString("selected_file", profileNames[selectedProfileIndex]);
}

void loadPersistedTargetWeight()
{
  float savedTargetWeight = preferences.getFloat("target_weight", targetWeight);
  if (savedTargetWeight > 0.0f)
  {
    targetWeight = savedTargetWeight;
  }
}

void persistTargetWeight()
{
  if (targetWeight > 0.0f)
  {
    preferences.putFloat("target_weight", targetWeight);
  }
}

void updateTargetWeightUi(bool force)
{
  static int lastSentTargetWeight = -1;
  static bool lastWasProfilePage = false;
  int value = (int)targetWeight;

  bool onProfilePage =
      currentPageId == (uint32_t)profileSelectionPageId ||
      currentPageId == (uint32_t)(0xFF000000 | profileSelectionPageId);

  if (!force && value == lastSentTargetWeight && onProfilePage == lastWasProfilePage)
  {
    return;
  }

  myNex.writeNum("targetWeight", value);

  if (onProfilePage)
  {
    sendNextionCommand("ntargetW.val=" + String(value));
  }

  lastSentTargetWeight = value;
  lastWasProfilePage = onProfilePage;
}

bool isBrewPage(uint32_t pageId)
{
  return pageId == (uint32_t)BREW_PAGE_ID ||
         pageId == (uint32_t)(0xFF000000 | BREW_PAGE_ID);
}

bool isProfileSelectionPage(uint32_t pageId)
{
  return pageId == (uint32_t)profileSelectionPageId ||
         pageId == (uint32_t)(0xFF000000 | profileSelectionPageId);
}

void syncTargetWeightFromDisplay()
{
  static int lastPersistedTargetWeight = -1;
  uint32_t rawTargetWeight = 0;

  // Guard against failed readNumber() responses and out-of-range values.
  if (!readNextionNumber("targetWeight", rawTargetWeight) ||
      rawTargetWeight < 1 || rawTargetWeight > 150)
  {
    return;
  }

  int manualTargetWeight = (int)rawTargetWeight;

  if (manualTargetWeight != (int)targetWeight)
  {
    Serial.print("[DEBUG] Target weight changed: "); Serial.print(targetWeight);
    Serial.print("g -> "); Serial.print(manualTargetWeight); Serial.println("g");
    targetWeight = (float)manualTargetWeight;
  }

  updateTargetWeightUi(false);

  if (manualTargetWeight != lastPersistedTargetWeight)
  {
    persistTargetWeight();
    lastPersistedTargetWeight = manualTargetWeight;
  }
}

// Marks the selected row by swapping its colours.
//
// The previous implementation used `.style=border` / `.borderw` / `.borderc`.
// None of those work here: `style` is not a writable attribute on any Nextion
// (and `border` is not a number), and the border attributes exist only on the
// Intelligent series, not on the Basic/Enhanced 3.5" panel this project uses.
// Every one of those commands failed, and each failure used to come back as a
// junk packet on UART2.
void updateProfileSelectionHighlight()
{
  for (int row = 0; row < PROFILE_ROWS_PER_PAGE; row++)
  {
    int profileIndex = profileListPageStart + row;
    if (profileIndex < 0 || profileIndex >= profileCount)
    {
      continue;
    }

    bool selected = (profileIndex == selectedProfileIndex);
    String component = "profile1.t" + String(row);
    sendNextionCommand(component + ".pco=" + String(selected ? PROFILE_ROW_PCO_SELECTED : PROFILE_ROW_PCO));
    sendNextionCommand(component + ".bco=" + String(selected ? PROFILE_ROW_BCO_SELECTED : PROFILE_ROW_BCO));
  }
}

void populateProfileList()
{
  for (int row = 0; row < PROFILE_ROWS_PER_PAGE; row++)
  {
    int profileIndex = profileListPageStart + row;
    String component = "profile1.t" + String(row);

    if (profileIndex >= 0 && profileIndex < profileCount)
    {
      String stem = profileNames[profileIndex];
      if (stem.endsWith(".csv"))
      {
        stem.remove(stem.length() - 4);
      }

      // Colours are set by updateProfileSelectionHighlight() below, which runs
      // for every visible row — no need to write them twice.
      sendNextionCommand(component + ".txt=\"" + nextionEscapedText(stem.c_str()) + "\"");
      sendNextionCommand(component + ".vis=1");
    }
    else
    {
      sendNextionCommand(component + ".vis=0");
    }
  }

  updateProfileSelectionHighlight();
}

bool selectProfile(int profileIndex)
{
  if (profileIndex < 0 || profileIndex >= profileCount)
  {
    return false;
  }

  if (!loadProfile(profileNames[profileIndex]))
  {
    return false;
  }

  selectedProfileIndex = profileIndex;
  profileStateDirty = true;
  myNex.writeStr("actProfile.txt", activeProfileName);
  updateProfileModeText();
  persistSelectedProfile();
  updateProfileSelectionHighlight();
  return true;
}

void handleProfileSelection(int rowIndex)
{
  int profileIndex = profileListPageStart + rowIndex;
  // Stay on the profile list after a selection — selectProfile() has already
  // moved the highlight to the new row, which is the feedback the user needs.
  // Leaving the page is the display's job, via the HMI's own back button.
  selectProfile(profileIndex);
}

void showProfileSelection()
{
  if (sdReady)
  {
    scanProfiles();
    lastProfileScanMs = millis();
  }

  profileListPageStart = 0;

  sendNextionCommand("page profile1");

  delay(50);   // test with 50-100 ms first

  populateProfileList();

  profilePageNeedsPopulate = false;
}
// Appends a touch event to the queue. If the queue is full the oldest event is
// dropped — the most recent touch is the one the user is waiting on.
void queueNextionTouchEvent(uint8_t pageId, uint8_t componentId, uint8_t eventType)
{
  if (nextionTouchQueueCount >= NEXTION_TOUCH_QUEUE_LEN)
  {
    nextionTouchQueueHead = (nextionTouchQueueHead + 1) % NEXTION_TOUCH_QUEUE_LEN;
    nextionTouchQueueCount--;
  }

  uint8_t tail = (nextionTouchQueueHead + nextionTouchQueueCount) % NEXTION_TOUCH_QUEUE_LEN;
  nextionTouchQueue[tail].pageId = pageId;
  nextionTouchQueue[tail].componentId = componentId;
  nextionTouchQueue[tail].eventType = eventType;
  nextionTouchQueueCount++;
}

// Plain scalar out-parameters rather than a NextionTouchEvent reference: the
// Arduino builder auto-generates prototypes for every function in the sketch,
// and keeping sketch-defined types out of those signatures avoids depending on
// where in the file it decides to place them.
bool popNextionTouchEvent(uint8_t &pageId, uint8_t &componentId, uint8_t &eventType)
{
  if (nextionTouchQueueCount == 0)
  {
    return false;
  }

  pageId = nextionTouchQueue[nextionTouchQueueHead].pageId;
  componentId = nextionTouchQueue[nextionTouchQueueHead].componentId;
  eventType = nextionTouchQueue[nextionTouchQueueHead].eventType;
  nextionTouchQueueHead = (nextionTouchQueueHead + 1) % NEXTION_TOUCH_QUEUE_LEN;
  nextionTouchQueueCount--;
  return true;
}

// Single entry point for everything arriving on UART2.
//   * 0x65 touch packets are queued for handleNextionProfileTouchEvents().
//   * A 0x71 numeric reply is decoded into `capture`, when one is supplied.
//   * Any other byte is dropped so the stream resynchronises. The old handler
//     returned on the first unrecognised byte, which let a single stray byte
//     block every queued touch behind it indefinitely.
// Returns true once a numeric reply has been captured.
bool nextionProcessRx(uint32_t *capture)
{
  while (Serial2.available() > 0)
  {
    int head = Serial2.peek();

    if (head == 0x65)
    {
      if (Serial2.available() < 7)
      {
        return false;  // rest of the packet is still in flight
      }

      uint8_t packet[7];
      Serial2.readBytes(packet, sizeof(packet));
      if (packet[4] == 0xFF && packet[5] == 0xFF && packet[6] == 0xFF)
      {
        queueNextionTouchEvent(packet[1], packet[2], packet[3]);
      }
      continue;
    }

    if (head == 0x71 && capture != NULL)
    {
      if (Serial2.available() < 8)
      {
        return false;
      }

      uint8_t packet[8];
      Serial2.readBytes(packet, sizeof(packet));
      if (packet[5] == 0xFF && packet[6] == 0xFF && packet[7] == 0xFF)
      {
        // 4-byte little-endian value.
        *capture = (uint32_t)packet[1] |
                   ((uint32_t)packet[2] << 8) |
                   ((uint32_t)packet[3] << 16) |
                   ((uint32_t)packet[4] << 24);
        return true;
      }
      continue;
    }

    Serial2.read();
  }

  return false;
}

void serviceNextionRx()
{
  nextionProcessRx(NULL);
}

// Waits for a single status byte from the display — the 0xFE / 0xFD handshake
// of `addt`. Touch events arriving in the meantime are queued as usual, so a
// press during a preview redraw is not lost.
bool nextionWaitForStatus(uint8_t expected, unsigned long timeoutMs)
{
  unsigned long startMs = millis();
  while (millis() - startMs < timeoutMs)
  {
    while (Serial2.available() > 0)
    {
      if (Serial2.peek() == 0x65)
      {
        if (Serial2.available() < 7)
        {
          break;  // rest of the touch packet is still in flight
        }

        uint8_t packet[7];
        Serial2.readBytes(packet, sizeof(packet));
        if (packet[4] == 0xFF && packet[5] == 0xFF && packet[6] == 0xFF)
        {
          queueNextionTouchEvent(packet[1], packet[2], packet[3]);
        }
        continue;
      }

      if ((uint8_t)Serial2.read() == expected)
      {
        return true;
      }
    }
    delay(1);
  }

  return false;
}

void handleNextionProfileTouchEvents()
{
  static uint8_t handledPressComponentId = 0xFF;

  serviceNextionRx();

  uint8_t pageId = 0;
  uint8_t componentId = 0;
  uint8_t eventType = 0;
  while (popNextionTouchEvent(pageId, componentId, eventType))
  {
    bool isProfileRowTouch =
        componentId >= PROFILE_TOUCH_COMPONENT_ID_MIN &&
        componentId <= PROFILE_TOUCH_COMPONENT_ID_MAX;

    bool isProfilePageEvent =
        pageId == (uint8_t)profileSelectionPageId ||
        pageId == (uint8_t)PROFILE_PAGE_ID_FALLBACK;

    if (!isProfileRowTouch || !isProfilePageEvent)
    {
      continue;
    }

    int rowIndex = componentId - PROFILE_TOUCH_COMPONENT_ID_MIN;

    // Some HMI objects are configured to send press events, others release.
    // Handle both edges while suppressing duplicate handling on release.
    if (eventType == 1)
    {
      handledPressComponentId = componentId;
      profileSelectionPageId = pageId;
      handleProfileSelection(rowIndex);
    }
    else if (eventType == 0)
    {
      if (handledPressComponentId == componentId)
      {
        handledPressComponentId = 0xFF;
        continue;
      }

      handledPressComponentId = 0xFF;
      profileSelectionPageId = pageId;
      handleProfileSelection(rowIndex);
    }
  }
}

// Optional EasyNextion trigger hook for opening the profile page.
// Can be bound in HMI with: printh 23 02 54 32
void trigger50()
{
  //showProfileSelection();
}

// Weight the pump is cut early by, so the drip-through after the pump stops
// lands the cup on target. Higher pressure at cut-off means more liquid still
// in the puck/group, hence a bigger offset. Bands are hard coded (bar → g).
float weightStopOffset(float pressure)
{
  if (pressure < 3.5f) return 0.2f;
  if (pressure < 4.5f) return 0.5f;
  if (pressure < 5.5f) return 0.75f;
  if (pressure < 6.5f) return 1.0f;
  if (pressure < 7.5f) return 1.5f;
  return 2.0f;
}

// Copies a profile's display name, truncating rather than overflowing.
static void setActiveProfileName(const char *name)
{
  strncpy(activeProfileName, name, sizeof(activeProfileName) - 1);
  activeProfileName[sizeof(activeProfileName) - 1] = '\0';
}

// Recognises the fixed ten-column layout this mod shipped with:
//   name,t1p,t1t,t2p,t2t,t3p,t3t,t4p,t4t,target_weight
static bool isLegacyProfileHeader(const String &header)
{
  return header.startsWith("name,t1p");
}

// Converts a legacy row into the polyline. Each of the four segments held its
// pressure for its own duration, so every point is a jump — the staircase is
// preserved exactly, and the profile still ends after the same total time.
static bool parseLegacyProfileRow(const String &row)
{
  char buf[PROFILE_CSV_BUFFER_LEN];
  row.toCharArray(buf, sizeof(buf));

  int steps[8] = { 0 };
  int idx = 0;
  char *token = strtok(buf, ",");
  while (token != NULL && idx < PROFILE_FIELD_COUNT)
  {
    if (idx == 0)
    {
      setActiveProfileName(token);
    }
    else if (idx <= 8)
    {
      steps[idx - 1] = atoi(token);
    }
    else
    {
      // Parsed so a round trip through Home Assistant does not lose it, but
      // never applied — see profileTargetWeightField.
      profileTargetWeightField = atof(token);
    }
    idx++;
    token = strtok(NULL, ",");
  }

  if (idx < PROFILE_FIELD_COUNT)
  {
    return false;
  }

  t1p = steps[0]; t1t = steps[1];
  t2p = steps[2]; t2t = steps[3];
  t3p = steps[4]; t3t = steps[5];
  t4p = steps[6]; t4t = steps[7];
  applyManualStepsToProfile();
  return true;
}

// Parses one line of the v2 format. Every line is `key,values…`, so unknown
// keys can be ignored and the format stays extensible:
//
//   # comment
//   name,Classic Espresso
//   target_weight,36.0
//   point,<seconds>,<bar>[,ramp|jump]
//
// Returns false only on a line that would corrupt the profile; an unknown key
// is not an error.
static bool parseProfileV2Line(char *line)
{
  char *key = strtok(line, ",");
  if (key == NULL)
  {
    return true;
  }

  if (strcmp(key, "name") == 0)
  {
    char *value = strtok(NULL, ",");
    if (value != NULL)
    {
      setActiveProfileName(value);
    }
    return true;
  }

  if (strcmp(key, "target_weight") == 0)
  {
    char *value = strtok(NULL, ",");
    if (value != NULL)
    {
      profileTargetWeightField = atof(value);
    }
    return true;
  }

  if (strcmp(key, "point") != 0)
  {
    return true;
  }

  char *secondsToken = strtok(NULL, ",");
  char *barToken = strtok(NULL, ",");
  char *modeToken = strtok(NULL, ",");
  if (secondsToken == NULL || barToken == NULL)
  {
    return false;
  }
  if (profilePointCount >= MAX_PROFILE_POINTS)
  {
    Serial.println("[SD] loadProfile: too many points, truncating");
    return false;
  }

  ProfilePoint &point = profilePoints[profilePointCount];
  point.seconds = constrain((float)atof(secondsToken), 0.0f, PROFILE_MAX_SECONDS);
  point.bar = constrain((float)atof(barToken), 0.0f, PROFILE_MAX_BAR);
  // Ramping is the default; only an explicit `jump` steps.
  point.jump = (modeToken != NULL && strcmp(modeToken, "jump") == 0);

  // profileTargetPressureAt() walks the points in order, so an unsorted file
  // would silently skip segments. Reject it instead.
  if (profilePointCount > 0 && point.seconds < profilePoints[profilePointCount - 1].seconds)
  {
    Serial.println("[SD] loadProfile: points are not in ascending time order");
    return false;
  }

  profilePointCount++;
  return true;
}

bool loadProfile(const char *filename)
{
  if (!sdReady)
  {
    Serial.println("[SD] loadProfile: sdReady=false");
    return false;
  }

  char path[MAX_PATH_LEN];
  snprintf(path, sizeof(path), "/profiles/%s", filename);
  Serial.print("[SD] loadProfile: opening '"); Serial.print(path); Serial.println("'");
  File f = SD.open(path);
  if (!f)
  {
    Serial.print("[SD] loadProfile: FAILED to open '"); Serial.print(path); Serial.println("'");
    return false;
  }
  Serial.print("[SD] loadProfile: opened OK — size="); Serial.println(f.size());

  strncpy(activeProfileFileStem, filename, sizeof(activeProfileFileStem) - 1);
  activeProfileFileStem[sizeof(activeProfileFileStem) - 1] = '\0';
  char *ext = strrchr(activeProfileFileStem, '.');
  if (ext != NULL)
  {
    *ext = '\0';
  }
  setActiveProfileName(activeProfileFileStem);

  // Parse into scratch state first: a half-read file must not leave the pump
  // following a profile that is partly the old one and partly the new.
  ProfilePoint previousPoints[MAX_PROFILE_POINTS];
  int previousCount = profilePointCount;
  memcpy(previousPoints, profilePoints, sizeof(previousPoints));
  profilePointCount = 0;
  profileTargetWeightField = 0.0f;

  String header = f.readStringUntil('\n');
  // Some editors write a UTF-8 byte-order mark. It is invisible, the old reader
  // skipped the header line without looking at it so it never mattered, and the
  // shipped blooming_espresso.csv has one — but it would defeat the format
  // sniffing below and make the file unreadable.
  if (header.length() >= 3 &&
      (uint8_t)header.charAt(0) == 0xEF &&
      (uint8_t)header.charAt(1) == 0xBB &&
      (uint8_t)header.charAt(2) == 0xBF)
  {
    header.remove(0, 3);
  }
  header.trim();

  bool ok;
  if (isLegacyProfileHeader(header))
  {
    String row = f.readStringUntil('\n');
    row.trim();
    ok = parseLegacyProfileRow(row);
    Serial.println("[SD] loadProfile: legacy 4-step format");
  }
  else
  {
    // In v2 the first line carries data like any other, so it is parsed here
    // rather than skipped as a header.
    ok = true;
    String line = header;
    while (line.length() > 0)
    {
      line.trim();
      if (line.length() > 0 && line.charAt(0) != '#')
      {
        char buf[PROFILE_CSV_BUFFER_LEN];
        line.toCharArray(buf, sizeof(buf));
        if (!parseProfileV2Line(buf))
        {
          ok = false;
          break;
        }
      }
      line = f.readStringUntil('\n');
    }

    if (ok && profilePointCount < PROFILE_MIN_POINTS)
    {
      Serial.print("[SD] loadProfile: only "); Serial.print(profilePointCount);
      Serial.println(" point(s) — not a usable profile");
      ok = false;
    }
  }
  f.close();

  if (!ok)
  {
    memcpy(profilePoints, previousPoints, sizeof(profilePoints));
    profilePointCount = previousCount;
    return false;
  }

  Serial.print("[SD] loadProfile: '"); Serial.print(activeProfileName);
  Serial.print("' — "); Serial.print(profilePointCount);
  Serial.print(" points over "); Serial.print(profileTotalSeconds(), 1); Serial.println("s");
  return true;
}

void startPendingObservation(float flowAtStop, float pressAtStop)
{
  if (!scaleConnected || lastWeightTime == 0)
  {
    pendingObservation = false;
    return;
  }

  unsigned long now = millis();
  pendingObservation = true;
  pendingObsTime = now;
  pendingFlowAtStop = flowAtStop;
  pendingPressAtStop = pressAtStop;
  pendingWeightAtStop = currentWeight;
  pendingStabilityCheckWeight = currentWeight;
  pendingStabilityCheckTime = now;
  pendingBrewTimeS = (int)((now - activeBrewingStart) / 1000);
}

void finalizePendingObservation(float finalWeight)
{
  pendingObservation = false;

  float extraWeight = finalWeight - pendingWeightAtStop;

  // Log the shot so the hard-coded pressure/offset table can be checked
  // against what actually landed in the cup.
  saveBrewLog(finalWeight, pendingBrewTimeS, pendingFlowAtStop, pendingPressAtStop, extraWeight);
}

void saveBrewLog(float finalWeight, int brewTimeS, float flow, float pres, float extra)
{
  if (!sdReady)
  {
    return;
  }

  File f = SD.open("/logs/brews.csv", FILE_WRITE);
  if (!f)
  {
    return;
  }

  f.print(millis());
  f.print(",");
  f.print(activeProfileName);
  f.print(",");
  f.print(finalWeight, 2);
  f.print(",");
  f.print(targetWeight, 2);
  f.print(",");
  f.print(brewTimeS);
  f.print(",");
  f.print(flow, 4);
  f.print(",");
  f.print(pres, 4);
  f.print(",");
  f.println(extra, 4);
  f.close();
}

void updateProfileModeText()
{
  static char lastProfileMode[PROFILE_NAME_MAX_LEN] = "";
  const char* newMode;

  if (pressureProfilingEnabled && remoteProfilingEnabled && sdReady)
  {
    newMode = activeProfileName;
  }
  else if (pressureProfilingEnabled)
  {
    newMode = "Manual";
  }
  else
  {
    newMode = "None";
  }

  myNex.writeStr("profileModetxt.txt", newMode);  // global var read by the brew page on Preinitialize

  // profileMode.txt only exists on the brew page, so writing it while the
  // profile list is open can only fail. Skip it: this runs on every display
  // refresh, and UART2 time on that page is better spent on touch events.
  if (!isProfileSelectionPage(currentPageId))
  {
    myNex.writeStr("profileMode.txt", newMode);  // direct write if currently on brew page
  }

  // Only log if mode actually changed
  if (strcmp(newMode, lastProfileMode) != 0)
  {
    Serial.print("[DEBUG] Profile mode changed: ");
    Serial.print(lastProfileMode);
    Serial.print(" -> ");
    Serial.println(newMode);
    strncpy(lastProfileMode, newMode, sizeof(lastProfileMode) - 1);
    lastProfileMode[sizeof(lastProfileMode) - 1] = '\0';
  }
}

void updateScaleConnectionUi()
{
  int connected = scaleConnected ? 1 : 0;
  
  if (connected != lastScaleConnectedUi)
  {
    Serial.print("[DEBUG] Scale connection changed: "); 
    Serial.print(lastScaleConnectedUi);
    Serial.print(" -> ");
    Serial.println(connected);

    // Update global variable (used by home page timer to refresh scalecon.val)
    myNex.writeNum("scaleConnected", connected);
    // Directly update p3.pic on home page (pic 20=connected, 21=disconnected).
    // The cross-page write fails when the home page is not loaded; with bkcmd=0
    // (set in setup()) that failure is silent instead of returning a junk packet.
    myNex.writeNum("home.p3.pic", connected ? 20 : 21);

    lastScaleConnectedUi = connected;
  }
}

void tryReconnectScale()
{
  if (brewActive || readRawBrewSwitchOn())
  {
    if (scale.isConnectionAttemptInProgress())
    {
      scale.cancelPendingConnect();
      lastScaleReconnectAttemptMs = 0;
    }
    return;
  }

  if (scaleConnected)
  {
    return;
  }

  if (scale.isConnectionAttemptInProgress())
  {
    return;
  }

  unsigned long now = millis();
  if (now - lastScaleReconnectAttemptMs < SCALE_RECONNECT_INTERVAL_MS)
  {
    return;
  }

  lastScaleReconnectAttemptMs = now;
  
  // With WiFi disabled, BLE has full control of the radio
  Serial.println("[DEBUG] Starting background BLE scale scan...");
  
  // Reinitialize and reconnect to scale (auto-discovers if MAC is empty)
  scale.beginConnect(SCALE_MAC_ADDRESS);
  scaleConnected = scale.isConnected();
  if (!scaleConnected)
  {
    flowRate = 0.0f;
  }
  
  updateScaleConnectionUi();
}

void tryReconnectWifi()
{
#ifndef DISABLE_WIFI_MQTT
  if (WiFi.status() == WL_CONNECTED)
  {
    wifiConnected = true;
    return;
  }

  wifiConnected = false;

  unsigned long now = millis();
  if (now - lastWifiReconnectAttemptMs < WIFI_RECONNECT_INTERVAL_MS)
  {
    return;
  }

  lastWifiReconnectAttemptMs = now;
  WiFi.begin(wifi_ssid, wifi_password);
#endif
}

#if !defined(DISABLE_WIFI_MQTT) && defined(ENABLE_HA_DISCOVERY)

// Every entity carries the same identifiers so Home Assistant files them all
// under one device instead of eight loose entities.
#define HA_DEVICE_BLOCK \
  "\"dev\":{\"ids\":[\"" ha_device_id "\"],\"name\":\"Mara X\"," \
  "\"mf\":\"Lelit\",\"mdl\":\"Mara X Pressure Mod\"}"

// Available whenever the controller itself is online.
#define HA_AVAILABILITY_BASE \
  "\"avty\":[{\"t\":\"" availability_topic "\"}]"

// Available only while the controller is online AND the machine is powered up.
// Without this the temperature entities would sit at a retained 0 °C all night
// and drag every history graph down to zero.
#define HA_AVAILABILITY_POWERED \
  "\"avty\":[{\"t\":\"" availability_topic "\"}," \
  "{\"t\":\"" power_topic "\",\"pl_avail\":\"1\",\"pl_not_avail\":\"0\"}]," \
  "\"avty_mode\":\"all\""

// Builds and publishes one retained discovery payload. `attributes` carries the
// entity-specific JSON (name, device class, unit, …) without a trailing comma.
static bool publishHaEntity(const char *component,
                            const char *objectId,
                            const char *stateTopic,
                            const char *attributes,
                            bool requiresMachinePower)
{
  String topic = String(ha_discovery_prefix "/") + component + "/" ha_device_id "/" + objectId + "/config";

  String payload = "{\"uniq_id\":\"" ha_device_id "_";
  payload += objectId;
  payload += "\",\"stat_t\":\"";
  payload += stateTopic;
  payload += "\",";
  payload += attributes;
  payload += ",";
  payload += requiresMachinePower ? HA_AVAILABILITY_POWERED : HA_AVAILABILITY_BASE;
  payload += "," HA_DEVICE_BLOCK "}";

  bool ok = mqttClient.publish(topic.c_str(), payload.c_str(), true);
  if (!ok)
  {
    Serial.print("[MQTT] Discovery publish failed for ");
    Serial.print(objectId);
    Serial.print(" (payload ");
    Serial.print(payload.length());
    Serial.println(" bytes)");
  }
  return ok;
}

// The profile picker. Its options are the profiles on the card, so unlike the
// other entities this has to be re-announced whenever that list changes —
// publishProfileState() calls it for exactly that reason.
void publishHaProfileSelect()
{
  String options = "";
  int announced = 0;
  for (int i = 0; i < profileCount && announced < PROFILE_SELECT_MAX_OPTIONS; i++)
  {
    String stem = profileNames[i];
    if (stem.endsWith(".csv"))
    {
      stem = stem.substring(0, stem.length() - 4);
    }
    if (options.length() > 0)
    {
      options += ",";
    }
    // Appended one piece at a time: on Arduino a bare string literal on the
    // left of + is not a String concatenation.
    options += "\"";
    options += stem;
    options += "\"";
    announced++;
  }

  if (announced < profileCount)
  {
    Serial.print("[MQTT] Profile select truncated to "); Serial.print(announced);
    Serial.print(" of "); Serial.print(profileCount); Serial.println(" profiles");
  }

  String attributes = "\"name\":\"Profile\",\"ic\":\"mdi:chart-bell-curve-cumulative\","
                      "\"cmd_t\":\"" profile_select_topic "\",\"ops\":[";
  attributes += options;
  attributes += "]";

  publishHaEntity("select", "profile", profile_name_topic, attributes.c_str(), false);
}

// Re-announced on every reconnect: the payloads are retained, but republishing
// makes the setup self-healing if the broker's retained store is ever cleared.
void publishHaDiscovery()
{
  publishHaEntity("sensor", "brewtemp", brewtemp_topic,
                  "\"name\":\"Brew temperature\",\"dev_cla\":\"temperature\","
                  "\"unit_of_meas\":\"°C\",\"stat_cla\":\"measurement\",\"sug_dsp_prc\":0", true);

  publishHaEntity("sensor", "steamtemp", steamtemp_topic,
                  "\"name\":\"Steam temperature\",\"dev_cla\":\"temperature\","
                  "\"unit_of_meas\":\"°C\",\"stat_cla\":\"measurement\",\"sug_dsp_prc\":0", true);

  publishHaEntity("sensor", "steamtargettemp", steamtargettemp_topic,
                  "\"name\":\"Steam target temperature\",\"dev_cla\":\"temperature\","
                  "\"unit_of_meas\":\"°C\",\"stat_cla\":\"measurement\",\"sug_dsp_prc\":0", true);

  publishHaEntity("sensor", "fastheat_timer", fastheat_topic,
                  "\"name\":\"Fast heat countdown\",\"dev_cla\":\"duration\","
                  "\"unit_of_meas\":\"s\",\"stat_cla\":\"measurement\"", true);

  // Not power-gated: the shot count is cumulative and stays meaningful while
  // the machine is off.
  publishHaEntity("sensor", "shots", shots_topic,
                  "\"name\":\"Shot count\",\"stat_cla\":\"total_increasing\","
                  "\"ic\":\"mdi:coffee\"", false);

  publishHaEntity("sensor", "debug", debug_topic,
                  "\"name\":\"Serial frame\",\"ent_cat\":\"diagnostic\","
                  "\"ic\":\"mdi:code-string\"", true);

  publishHaEntity("binary_sensor", "heatingelement", heatingElement_topic,
                  "\"name\":\"Heating element\",\"dev_cla\":\"running\","
                  "\"pl_on\":\"1\",\"pl_off\":\"0\"", true);

  // Not power-gated — this entity *is* the power state.
  publishHaEntity("binary_sensor", "power_state", power_topic,
                  "\"name\":\"Power\",\"dev_cla\":\"power\","
                  "\"pl_on\":\"1\",\"pl_off\":\"0\"", false);

  // Every profile command is answered here, so a rejected edit is visible in
  // Home Assistant instead of only on the serial console.
  publishHaEntity("sensor", "profile_result", profile_result_topic,
                  "\"name\":\"Profile command result\",\"ent_cat\":\"diagnostic\","
                  "\"ic\":\"mdi:message-alert-outline\"", false);

  publishHaProfileSelect();

  Serial.println("[MQTT] Home Assistant discovery published");
}
#endif

#ifndef DISABLE_WIFI_MQTT

// Profile names become file names, so only characters that cannot escape the
// /profiles directory are allowed. Rejecting '.' outright rules out '..' and
// any extension games without needing to reason about path traversal.
static bool sanitizeProfileStem(const char *raw, char *out, size_t outLen)
{
  if (raw == NULL)
  {
    return false;
  }

  size_t length = strlen(raw);
  // Room for the stem plus the ".csv" the caller appends.
  if (length == 0 || length + 5 > outLen)
  {
    return false;
  }

  for (size_t i = 0; i < length; i++)
  {
    char c = raw[i];
    bool allowed = (c >= 'a' && c <= 'z') || (c >= 'A' && c <= 'Z') ||
                   (c >= '0' && c <= '9') || c == '_' || c == '-';
    if (!allowed)
    {
      return false;
    }
    out[i] = c;
  }
  out[length] = '\0';
  return true;
}

// Serialises the loaded profile back into the v2 format — the same bytes that
// are written to the card, so what Home Assistant edits is what is stored.
void buildProfileCsv(String &out)
{
  out = "# marax profile v2\n";
  out += "name,";
  out += activeProfileName;
  out += "\n";

  if (profileTargetWeightField > 0.0f)
  {
    out += "target_weight,";
    out += String(profileTargetWeightField, 1);
    out += "\n";
  }

  for (int i = 0; i < profilePointCount; i++)
  {
    out += "point,";
    out += String(profilePoints[i].seconds, 1);
    out += ",";
    out += String(profilePoints[i].bar, 1);
    out += profilePoints[i].jump ? ",jump\n" : ",ramp\n";
  }
}

// Parses a body with the real reader, then puts back whatever was loaded
// before. Validating with the same code that will later read the file off the
// card is the point: nothing can be accepted here and rejected on reload.
static bool validateProfileBody(const char *body)
{
  ProfilePoint savedPoints[MAX_PROFILE_POINTS];
  char savedName[PROFILE_NAME_MAX_LEN];
  int savedCount = profilePointCount;
  float savedWeight = profileTargetWeightField;
  memcpy(savedPoints, profilePoints, sizeof(savedPoints));
  strncpy(savedName, activeProfileName, sizeof(savedName));

  profilePointCount = 0;
  profileTargetWeightField = 0.0f;

  bool ok = true;
  const char *cursor = body;
  char line[PROFILE_CSV_BUFFER_LEN];

  while (*cursor != '\0' && ok)
  {
    size_t n = 0;
    while (*cursor != '\0' && *cursor != '\n' && n < sizeof(line) - 1)
    {
      line[n++] = *cursor++;
    }
    // Ran out of buffer before the end of the line: malformed, not something
    // to truncate silently.
    if (*cursor != '\0' && *cursor != '\n')
    {
      ok = false;
      break;
    }
    if (*cursor == '\n')
    {
      cursor++;
    }
    line[n] = '\0';

    while (n > 0 && (line[n - 1] == '\r' || line[n - 1] == ' ' || line[n - 1] == '\t'))
    {
      line[--n] = '\0';
    }

    if (n == 0 || line[0] == '#')
    {
      continue;
    }
    if (!parseProfileV2Line(line))
    {
      ok = false;
    }
  }

  if (ok && profilePointCount < PROFILE_MIN_POINTS)
  {
    ok = false;
  }

  memcpy(profilePoints, savedPoints, sizeof(profilePoints));
  profilePointCount = savedCount;
  profileTargetWeightField = savedWeight;
  strncpy(activeProfileName, savedName, sizeof(activeProfileName));
  return ok;
}

static bool writeProfileFile(const char *stem, const char *body)
{
  if (!SD.exists("/profiles"))
  {
    SD.mkdir("/profiles");
  }

  char path[MAX_PATH_LEN];
  snprintf(path, sizeof(path), "/profiles/%s.csv", stem);

  // On the ESP32 core FILE_WRITE is "w", so this replaces the file rather than
  // appending to it.
  File f = SD.open(path, FILE_WRITE);
  if (!f)
  {
    Serial.print("[SD] writeProfileFile: cannot open "); Serial.println(path);
    return false;
  }

  size_t expected = strlen(body);
  size_t written = f.print(body);
  // The reader takes a line at a time, so a body that does not end in a
  // newline would lose its last point on the way back in.
  if (expected > 0 && body[expected - 1] != '\n')
  {
    f.print('\n');
  }
  f.close();

  if (written != expected)
  {
    Serial.print("[SD] writeProfileFile: short write to "); Serial.println(path);
    return false;
  }

  Serial.print("[SD] writeProfileFile: wrote "); Serial.print(written);
  Serial.print(" bytes to "); Serial.println(path);
  return true;
}

static void publishProfileResult(const char *text)
{
  Serial.print("[MQTT] Profile command: "); Serial.println(text);
  // Not retained: this is the answer to one command, not a state a fresh
  // subscriber should be handed on connect.
  mqttClient.publish(profile_result_topic, text, false);
}

// Refreshes the retained profile topics. Called from the main loop whenever
// profileStateDirty is set, so callers only have to flag the change.
void publishProfileState()
{
  if (!mqttClient.connected())
  {
    return;
  }

  String list = "";
  for (int i = 0; i < profileCount; i++)
  {
    String stem = profileNames[i];
    if (stem.endsWith(".csv"))
    {
      stem = stem.substring(0, stem.length() - 4);
    }
    if (list.length() > 0)
    {
      list += ",";
    }
    list += stem;
  }

  mqttClient.publish(profile_list_topic, list.c_str(), true);
  mqttClient.publish(profile_name_topic, activeProfileFileStem, true);

  String csv;
  buildProfileCsv(csv);
  if (!mqttClient.publish(profile_active_topic, csv.c_str(), true))
  {
    Serial.print("[MQTT] Active profile body did not fit the buffer (");
    Serial.print(csv.length()); Serial.println(" bytes)");
  }

#ifdef ENABLE_HA_DISCOVERY
  publishHaProfileSelect();
#endif
}

// Finds a profile by stem in the scanned list. Returns -1 when it is not there.
static int findProfileIndex(const char *stem)
{
  char wanted[PROFILE_NAME_MAX_LEN];
  snprintf(wanted, sizeof(wanted), "%s.csv", stem);
  for (int i = 0; i < profileCount; i++)
  {
    if (strcmp(profileNames[i], wanted) == 0)
    {
      return i;
    }
  }
  return -1;
}

// Carries out whatever the MQTT callback recorded. Runs from the main loop so
// the SD card is only touched at a moment of our choosing.
void processPendingProfileCommand()
{
  ProfileCommandKind kind = pendingProfileCommand.kind;
  if (kind == PROFILE_CMD_NONE)
  {
    return;
  }

  if (!mqttClient.connected())
  {
    // Nowhere to report the outcome; drop it rather than acting unannounced.
    pendingProfileCommand.kind = PROFILE_CMD_NONE;
    return;
  }

  if (kind == PROFILE_CMD_TOO_LARGE)
  {
    publishProfileResult("error: profile body too large");
    pendingProfileCommand.kind = PROFILE_CMD_NONE;
    return;
  }

  // Never write to the card or change the running profile mid-shot. Refusing
  // outright is clearer than queueing the command to land seconds later.
  if (brewActive)
  {
    publishProfileResult("error: brew in progress");
    pendingProfileCommand.kind = PROFILE_CMD_NONE;
    return;
  }

  if (!sdReady)
  {
    publishProfileResult("error: no SD card");
    pendingProfileCommand.kind = PROFILE_CMD_NONE;
    return;
  }

  char stem[PROFILE_NAME_MAX_LEN];
  char message[96];

  if (kind == PROFILE_CMD_SELECT)
  {
    // For select the stem arrives as the payload, not in the topic.
    if (!sanitizeProfileStem(pendingProfileCommand.body, stem, sizeof(stem)))
    {
      publishProfileResult("error: invalid profile name");
    }
    else
    {
      int index = findProfileIndex(stem);
      if (index < 0)
      {
        snprintf(message, sizeof(message), "error: no profile '%s'", stem);
        publishProfileResult(message);
      }
      else if (!selectProfile(index))
      {
        snprintf(message, sizeof(message), "error: could not load '%s'", stem);
        publishProfileResult(message);
      }
      else
      {
        snprintf(message, sizeof(message), "ok: selected '%s'", stem);
        publishProfileResult(message);
      }
    }
  }
  else if (kind == PROFILE_CMD_SAVE)
  {
    if (!sanitizeProfileStem(pendingProfileCommand.stem, stem, sizeof(stem)))
    {
      publishProfileResult("error: invalid profile name");
    }
    else if (!validateProfileBody(pendingProfileCommand.body))
    {
      publishProfileResult("error: profile body rejected by the parser");
    }
    else if (!writeProfileFile(stem, pendingProfileCommand.body))
    {
      publishProfileResult("error: could not write to the SD card");
    }
    else
    {
      scanProfiles();
      lastProfileScanMs = millis();

      // Editing the profile that is loaded should take effect straight away.
      if (strcmp(stem, activeProfileFileStem) == 0)
      {
        int index = findProfileIndex(stem);
        if (index >= 0)
        {
          selectProfile(index);
        }
      }

      profileStateDirty = true;
      snprintf(message, sizeof(message), "ok: saved '%s'", stem);
      publishProfileResult(message);
    }
  }
  else if (kind == PROFILE_CMD_DELETE)
  {
    if (!sanitizeProfileStem(pendingProfileCommand.stem, stem, sizeof(stem)))
    {
      publishProfileResult("error: invalid profile name");
    }
    else if (strcmp(stem, activeProfileFileStem) == 0)
    {
      // Deleting the loaded profile would leave the pump following something
      // with no file behind it, and the picker pointing at a name that is gone.
      publishProfileResult("error: select another profile first");
    }
    else if (findProfileIndex(stem) < 0)
    {
      snprintf(message, sizeof(message), "error: no profile '%s'", stem);
      publishProfileResult(message);
    }
    else
    {
      char path[MAX_PATH_LEN];
      snprintf(path, sizeof(path), "/profiles/%s.csv", stem);
      if (!SD.remove(path))
      {
        publishProfileResult("error: could not delete the file");
      }
      else
      {
        scanProfiles();
        lastProfileScanMs = millis();
        profileStateDirty = true;
        snprintf(message, sizeof(message), "ok: deleted '%s'", stem);
        publishProfileResult(message);
      }
    }
  }

  pendingProfileCommand.kind = PROFILE_CMD_NONE;
}
#endif

void tryReconnectMqtt()
{
#ifndef DISABLE_WIFI_MQTT
  if (mqttClient.connected())
  {
    return;
  }

  if (!wifiConnected || WiFi.status() != WL_CONNECTED)
  {
    return;
  }

  unsigned long now = millis();
  if (now - lastMqttReconnectAttemptMs < MQTT_RECONNECT_INTERVAL_MS)
  {
    return;
  }

  lastMqttReconnectAttemptMs = now;

  // Retained last will: the broker publishes "offline" here for us if the
  // connection dies without a clean disconnect.
  if (mqttClient.connect("MaraXMod", mqtt_user, mqtt_password,
                         availability_topic, 0, true, "offline"))
  {
    mqttClient.publish(availability_topic, "online", true);

    mqttClient.subscribe(profile_select_topic);
    mqttClient.subscribe(profile_save_prefix "+");
    mqttClient.subscribe(profile_delete_prefix "+");
    // The retained profile topics are refreshed from the main loop.
    profileStateDirty = true;

#ifdef ENABLE_HA_DISCOVERY
    publishHaDiscovery();
#endif
  }
#endif
}

void scanProfiles()
{
  profileCount = 0;
  profileListStr = "";

  if (!sdReady)
  {
    Serial.println("[SD] scanProfiles: sdReady=false — skipping");
    return;
  }

  Serial.println("[SD] scanProfiles: opening /profiles");
  File dir = SD.open("/profiles");
  if (!dir)
  {
    Serial.println("[SD] scanProfiles: FAILED to open /profiles directory");
    return;
  }
  Serial.println("[SD] scanProfiles: directory opened OK");

  int skipped = 0;
  while (profileCount < MAX_PROFILES)
  {
    File entry = dir.openNextFile();
    if (!entry)
    {
      break;
    }

    String rawName = entry.name();
    bool isDir = entry.isDirectory();
    Serial.print("[SD] scanProfiles: entry='" ); Serial.print(rawName);
    Serial.print("' isDir="); Serial.println(isDir);

    if (!isDir)
    {
      String name = rawName;
      int slashIndex = name.lastIndexOf('/');
      if (slashIndex >= 0)
      {
        name = name.substring(slashIndex + 1);
      }

      if (name.endsWith(".csv"))
      {
        name.toCharArray(profileNames[profileCount], sizeof(profileNames[profileCount]));
        profileNames[profileCount][sizeof(profileNames[profileCount]) - 1] = '\0';
        if (profileListStr.length() > 0)
        {
          profileListStr += ",";
        }
        profileListStr += name.substring(0, name.length() - 4);
        Serial.print("[SD] scanProfiles: added profile '"); Serial.print(profileNames[profileCount]); Serial.println("'");
        profileCount++;
      }
      else
      {
        Serial.print("[SD] scanProfiles: skipped (not .csv): "); Serial.println(name);
        skipped++;
      }
    }
    entry.close();
  }
  dir.close();
  Serial.print("[SD] scanProfiles: done — found "); Serial.print(profileCount);
  Serial.print(" profiles, skipped "); Serial.println(skipped);
}

void updateScale()
{
  if (!scaleConnected && (brewActive || readRawBrewSwitchOn()))
  {
    if (scale.isConnectionAttemptInProgress())
    {
      scale.cancelPendingConnect();
      lastScaleReconnectAttemptMs = 0;
    }
    return;
  }

  if (!scaleConnected && scale.pollConnect())
  {
    scaleConnected = true;
    updateScaleConnectionUi();
  }

  if (!scaleConnected)
  {
    return;
  }

  if (!scale.isConnected())
  {
    scale.disconnect();
    scaleConnected = false;
    flowRate = 0.0f;
    updateScaleConnectionUi();
    return;
  }

  if (scale.heartbeatRequired())
  {
    scale.heartbeat();
  }

  if (scale.newWeightAvailable())
  {
    float newWeight = scale.getWeight();
    unsigned long now = millis();
    unsigned long dt = now - lastWeightTime;

    prevWeight = currentWeight;
    currentWeight = newWeight;

    if (dt > 0 && lastWeightTime > 0)
    {
      flowRate = (currentWeight - prevWeight) / (dt / 1000.0f);
    }

    lastWeightTime = now;
  }
}

void checkPendingObservation()
{
  if (!pendingObservation)
  {
    return;
  }
  unsigned long now = millis();
  if (now - pendingObsTime >= OBSERVATION_MAX_WAIT_MS)
  {
    // Timeout reached with unstable weight: keep the brew record using the
    // current reading as finalWeight.
    finalizePendingObservation(currentWeight);
    return;
  }

  if (now - pendingStabilityCheckTime < WEIGHT_STABLE_WINDOW_MS)
  {
    return;
  }

  if (currentWeight - pendingStabilityCheckWeight >= WEIGHT_STABLE_THRESHOLD)
  {
    pendingStabilityCheckWeight = currentWeight;
    pendingStabilityCheckTime = now;
    return;
  }

  // Stable within the configured window: accept this as the final weight.
  finalizePendingObservation(currentWeight);
}

// Gets "live" Info during brew
void liveData()
{
  if (brewActive)
  {
    unsigned long nowMs = millis();

    // Throttle the display writes. Unthrottled they ran on every loop
    // iteration: at 115200 baud the UART2 TX buffer fills, Serial2.print()
    // blocks, and the display ends up pacing the loop that runs pressure
    // control and the weight cut-off.
    static unsigned long lastLiveDataMs = 0;
    if (nowMs - lastLiveDataMs >= LIVE_DATA_REFRESH_MS)
    {
      lastLiveDataMs = nowMs;

      // Write Brew Temp
      myNex.writeNum("brewTemp", brewTemp);
      // Write BrewTimer
      myNex.writeNum("brewTime", (int)((nowMs - activeBrewingStart) / 1000));
      // Write Live Pressure as normal number
      float pressure = getPressure();
      // barvar is an XFloat with 2 decimal places: it displays value/100.
      myNex.writeNum("barvar.val", (int)(pressure * 100));
      // Map the pressure to wave pixels in graph (0–10 bar → 0–180 px).
      // getPressure() can return up to 12 bar, so clamp before mapping to keep
      // the trace inside the waveform.
      int pressureCentibar = constrain((int)(pressure * 100), 0, 1000);
      barGraphValue = map(pressureCentibar, 0, 1000, 0, 180);
      myNex.writeNum("barwave.val", barGraphValue);

      if (scaleConnected)
      {
        myNex.writeNum("weightVar.val", (int)(currentWeight * 10));
        myNex.writeNum("flowVar.val", (int)(flowRate * 100));
      }
    }

    // Periodic dimmer diagnostics (every 1 second during brew)
    // lastDimmerDebugMs and lastZeroCrossCountDebug are globals seeded in
    // brewDetect() at brew start, so the very first reading is always accurate.
    if (nowMs - lastDimmerDebugMs >= 1000)
    {
      uint32_t snapshot = zeroCrossCount;  // single read, ISR-safe for uint32
      uint32_t crossingsPerSec = snapshot - lastZeroCrossCountDebug;
      lastZeroCrossCountDebug = snapshot;
      unsigned long windowMs = nowMs - lastDimmerDebugMs;  // actual elapsed time
      lastDimmerDebugMs = nowMs;

      uint8_t brt = pumpBrightness;  // snapshot volatile
      uint32_t delayUs = 0;
      if (brt > 0 && brt < 255)
        delayUs = map(brt, 0, 255, 10000, 100);

      // Normalise: scale to per-second if the window was stretched by Nextion I/O
      uint32_t zcPerSec = (windowMs > 0) ? (crossingsPerSec * 1000UL / windowMs) : crossingsPerSec;

      Serial.print("[DIMMER] brightness="); Serial.print(brt);
      Serial.print("/255 ("); Serial.print(brt * 100 / 255); Serial.print("%)");
      if (brt == 0)        Serial.print("  PUMP OFF");
      else if (brt == 255) Serial.print("  FULL POWER");
      else { Serial.print("  delay="); Serial.print(delayUs); Serial.print("µs"); }
      Serial.print("  ZC/s="); Serial.print(zcPerSec);
      Serial.print(" (window="); Serial.print(windowMs); Serial.print("ms)");
      if (zcPerSec < 80 || zcPerSec > 120)
        Serial.print("  *** ABNORMAL (expect ~100 at 50 Hz) ***");
      Serial.println();
    }
  }
}

float getPressure()
{
  // Sensor:
  //  - Supply: 5V
  //  - Output: 0.4V to 2.4V
  //  - Range: 0 to 1.2 MPa ~= 0 to 12 bar
  //
  // ESP32-S3 ADC:
  //  - 3.3V reference
  //  - analogReadResolution(12) → range 0..4095
  //  - NOTE: ESP32 ADC has non-linearity near 0V and 3.3V rails.
  //    The sensor output range (0.4V–2.4V) sits in the linear region, so
  //    this is not a practical concern here.

  const float sensorMinV = 0.4f;
  const float sensorMaxV = 2.4f;
  const float sensorMaxBar = 12.0f;

  sensorVal = (float)analogRead(PRESSURE_SENSOR_PIN);
  filteredVal = (alpha * filteredVal) + ((1.0 - alpha) * sensorVal);
  voltage = (filteredVal / 4096.0f) * 3.3f; // 12-bit: divide by 4096

  float Pressure = (voltage - sensorMinV) * sensorMaxBar / (sensorMaxV - sensorMinV);

  if (Pressure < 0.0f) return 0.0f;
  if (Pressure > sensorMaxBar) return sensorMaxBar;
  return Pressure;
}

// Reads a numeric component from the display. Returns false and leaves `value`
// untouched when the display did not answer in time.
//
// This deliberately does not use EasyNextionLibrary's readNumber(): that one
// begins by discarding every byte already in the RX buffer that is not part of
// its own '#' custom protocol — touch events included — and then scans past
// anything that is not 0x71, so a profile selection made while a read was in
// flight was silently thrown away. Going through nextionProcessRx() keeps
// touch events queued while we wait for the reply.
bool readNextionNumber(const char *component, uint32_t &value)
{
  // Clear anything already pending (touches are kept) so a late reply to an
  // earlier `get` cannot be mistaken for the answer to this one.
  nextionProcessRx(NULL);

  sendNextionCommand("get " + String(component));

  uint32_t received = 0;
  unsigned long startMs = millis();
  while (millis() - startMs < NEXTION_READ_TIMEOUT_MS)
  {
    if (nextionProcessRx(&received))
    {
      value = received;
      return true;
    }
    delay(1);  // yield to FreeRTOS instead of spinning on the UART
  }

  return false;
}

// Reads one manual-mode profile pressure from the display. Values outside the
// sensor range are treated as garbled and leave the current value alone.
void readManualProfilePressure(const char *component, int &pressureBar)
{
  uint32_t value = 0;
  if (!readNextionNumber(component, value) || value > MANUAL_PRESSURE_MAX_BAR)
  {
    return;
  }
  pressureBar = (int)value;
}

// Reads one manual-mode segment duration from the display, with the same
// guard against failed reads.
void readManualProfileTime(const char *component, int &segmentSeconds)
{
  uint32_t value = 0;
  if (!readNextionNumber(component, value) || value > MANUAL_SEGMENT_MAX_SECONDS)
  {
    return;
  }
  segmentSeconds = (int)value;
}

void readSettigs()
{
  if ((millis() - readSettigsRefreshTimer > 4000) && !brewActive && !pendingObservation)
  {
    if (sdReady && (millis() - lastProfileScanMs >= PROFILE_SCAN_INTERVAL_MS))
    {
      int previousProfileCount = profileCount;
      scanProfiles();
      lastProfileScanMs = millis();
      if (previousProfileCount != profileCount)
      {
        Serial.print("[DEBUG] Profile count changed: "); Serial.print(previousProfileCount);
        Serial.print(" -> "); Serial.println(profileCount);
        populateProfileList();
      }
    }

    getPressure();
    
    // Read Nextion variables (only log if values change)
    static int lastPPEnabled = -1;
    static int lastRemoteEnabled = -1;
    
    // A failed read must not silently switch profiling on: readNextionNumber()
    // rejects the sentinel, and only 0/1 are accepted as real answers.
    uint32_t rawPP = 0;
    if (readNextionNumber("pPEnabled", rawPP) && rawPP <= 1)
    {
      pressureProfilingEnabled = (rawPP != 0);
    }
    uint32_t rawRemote = 0;
    if (readNextionNumber("remoteEnabled", rawRemote) && rawRemote <= 1)
    {
      remoteProfilingEnabled = (rawRemote != 0);
    }
    
    // Only log if settings actually changed
    if (pressureProfilingEnabled != lastPPEnabled || 
        remoteProfilingEnabled != lastRemoteEnabled)
    {
      Serial.print("[DEBUG] Settings changed - pPEnabled:"); Serial.print(pressureProfilingEnabled);
      Serial.print(" remoteEnabled:"); Serial.println(remoteProfilingEnabled);
      
      lastPPEnabled = pressureProfilingEnabled;
      lastRemoteEnabled = remoteProfilingEnabled;
    }
    
    // Manual mode (pressure profiling ON, remote OFF): read manual pressure settings.
    // Every value is checked for the failure sentinel and range-checked before
    // it is applied — a single dropped display response must not corrupt the
    // profile that pressureProfile() is running.
    if (!remoteProfilingEnabled && pressureProfilingEnabled)
    {
      readManualProfilePressure("t1p", t1p);
      readManualProfilePressure("t2p", t2p);
      readManualProfilePressure("t3p", t3p);
      readManualProfilePressure("t4p", t4p);

      readManualProfileTime("t1t", t1t);
      readManualProfileTime("t2t", t2t);
      readManualProfileTime("t3t", t3t);
      readManualProfileTime("t4t", t4t);

      // The pump follows profilePoints[] whatever the source, so the four
      // display fields are folded into the same representation.
      applyManualStepsToProfile();
    }
    
    // targetWeight is authoritative from display input when available.
    syncTargetWeightFromDisplay();

    updateProfileModeText();
    readSettigsRefreshTimer = millis();
  }
}

void updateDisplay()
{
  // Wrap-safe interval check: pageRefreshTimer holds the last refresh time.
  if ((millis() - pageRefreshTimer >= REFRESH_SCREEN_EVERY) && !brewActive)
  {
    if (POWER_ON && displayIsInSleep)
    {
      Serial.println("[DEBUG] Display waking up");
      myNex.writeNum("sleep", 0);
      displayIsInSleep = false;
    }
    else if (!POWER_ON && !displayIsInSleep)
    {
      Serial.println("[DEBUG] Display going to sleep");
      myNex.writeStr("page home");
      myNex.writeNum("sleep", 1);
      displayIsInSleep = true;
    }

    // Throttled debug output - only every 10 seconds
    static unsigned long lastDisplayDebugMs = 0;
    if (millis() - lastDisplayDebugMs > 10000) {
      Serial.print("[DEBUG] Display status — brewTemp:"); Serial.print(brewTemp);
      Serial.print(" steamTemp:"); Serial.print(steamTemp);
      Serial.print(" POWER_ON:"); Serial.print(POWER_ON);
      Serial.print(" page:"); Serial.println(currentPageId);
      lastDisplayDebugMs = millis();
    }
    
    // Send updated values to display (no debug spam)
    myNex.writeNum("brewTemp", brewTemp);
    myNex.writeNum("steamTemp", steamTemp);
    myNex.writeStr("actProfile.txt", activeProfileName);
    updateProfileModeText();
    
    updateScaleConnectionUi();

    // Keep the previous page id when the display does not answer, rather than
    // letting the failure sentinel masquerade as a page change.
    readNextionNumber("dp", currentPageId);

    if (isProfileSelectionPage(currentPageId))
    {
      // Keep MCU targetWeight synchronized from profile page selector.
      syncTargetWeightFromDisplay();
      updateTargetWeightUi(false);
    }

    if (currentPageId != lastPageId)
    {
      if (isProfileSelectionPage(currentPageId))
      {
        profilePageNeedsPopulate = true;
      }
      if (isBrewPage(currentPageId))
      {
        brewPreviewNeedsDraw = true;
      }
      lastPageId = currentPageId;
    }

    // The preview is only ever drawn while idle: once a shot is running the
    // graph belongs to the live trace, and after it finishes the result stays
    // on screen until the page is left and re-entered.
    if (isBrewPage(currentPageId))
    {
      uint32_t signature = profileSegmentSignature();
      if (signature != lastPreviewSignature)
      {
        lastPreviewSignature = signature;
        brewPreviewNeedsDraw = true;
      }

      if (brewPreviewNeedsDraw)
      {
        drawTargetProfilePreview();
        brewPreviewNeedsDraw = false;
      }
    }

    if (profilePageNeedsPopulate &&
        isProfileSelectionPage(currentPageId))
    {
      populateProfileList();
      profilePageNeedsPopulate = false;
    }

    // These are home-page components: writing them while the profile list is
    // open can only fail, so skip the traffic on the page where touch latency
    // matters. Every other page still gets them unconditionally.
    if (!isProfileSelectionPage(currentPageId))
    {
      myNex.writeNum("tarsteam.val", steamTargetTemp);
      myNex.writeNum("fastheattimer.val", fastHeatingCountDown);
      myNex.writeNum("heatingel.val", heatingElementOn);
    }

    // Read settings (except while the brew page is open)
    if (!isBrewPage(currentPageId))
    {
      readSettigs();
    }

    // Check if we're on cleaning page
    if (currentPageId == 4278190086 || currentPageId == 6)
    {
      cleaningModeActive = true;
    }
    else
    {
      cleaningShots = 0;
      cleaningShotsWater = 0;
      cleaningModeActive = false;
    }

    pageRefreshTimer = millis();
  }
}

// Controls the dimmer during idle (not brewing).
// When pressure is detected the boiler is full — cut dimmer so pump stops.
// When pressure drops back to zero the boiler needs water — restore dimmer
// to 100% so GiCar can run the pump through it unimpeded.
void updateIdlePumpControl()
{
  if (brewActive) return;  // During brew, pressureProfile() owns the dimmer

  // Do not latch boiler-full before the MaraX reports that it is actually on.
  // During boot, steamTemp is still 0 and the pressure filter may not yet
  // reflect the real sensor value.
  if (!POWER_ON)
  {
    if (pumpBrightness != 255) setPumpBrightness(255);
    return;
  }

  // During cleaning/backflush the GiCar drives the pump on each lever press.
  // Keep the dimmer fully open so backflush pressure can build — the idle
  // "boiler full" cut-off below must not fight it.
  if (cleaningModeActive || cleaningRunActive)
  {
    if (pumpBrightness != 255) setPumpBrightness(255);
    return;
  }

  boilerFullPressureBar = (steamTemp > 80) ? 5.0f : 0.5f;
  float p = getPressure();
  if (p > boilerFullPressureBar)
  {
    // Boiler has pressure — latch off and cut power
    boilerFullLatch = true;
    if (pumpBrightness != 0) setPumpBrightness(0);
  }
  else if (!boilerFullLatch)
  {
    // No pressure and not latched — allow GiCar to run the pump
    if (pumpBrightness != 255) setPumpBrightness(255);
  }
  // If latched and pressure is gone: stay at 0 until brew ends
}

void setPressure(float targetValue)
{
  int pumpValue;
  float currentPressure = (getPressure() - 2.2f);

  if (targetValue == 0 || currentPressure > targetValue)
  {
    pumpValue = 0;
  }
  else
  {
    float diff = targetValue - currentPressure;
    pumpValue = 255 / (1.f + exp(2.f - diff / 0.9f));
  }
  setPumpBrightness(pumpValue);
}

// How long the profile runs: the time of its last point. Zero means nothing is
// configured, which the callers treat as "no profiling".
float profileTotalSeconds()
{
  if (profilePointCount <= 0)
  {
    return 0.0f;
  }
  return profilePoints[profilePointCount - 1].seconds;
}

// Target pressure (bar) `second` seconds into the shot, interpolated along the
// polyline. Before the first point and after the last one the nearest point's
// pressure is held — running out of profile must not drop the pump to zero
// mid-shot, or a brew-by-weight shot would stop short of its target.
float profileTargetPressureAt(float second)
{
  if (profilePointCount <= 0)
  {
    return 0.0f;
  }
  if (second <= profilePoints[0].seconds)
  {
    return profilePoints[0].bar;
  }

  for (int i = 1; i < profilePointCount; i++)
  {
    const ProfilePoint &previous = profilePoints[i - 1];
    const ProfilePoint &current = profilePoints[i];

    if (second >= current.seconds)
    {
      continue;
    }

    if (current.jump)
    {
      // Not there yet, and this point is a step: the previous pressure stands.
      return previous.bar;
    }

    float span = current.seconds - previous.seconds;
    if (span <= 0.0f)
    {
      // Two points at the same instant — a vertical edge, so the later one wins.
      return current.bar;
    }
    float progress = (second - previous.seconds) / span;
    return previous.bar + progress * (current.bar - previous.bar);
  }

  return profilePoints[profilePointCount - 1].bar;
}

// Converts the display's four manual steps into the polyline the pump follows.
// Each step holds its pressure for its own duration, so every point is a jump —
// which is exactly the staircase manual mode has always produced.
void applyManualStepsToProfile()
{
  const int pressures[4] = { t1p, t2p, t3p, t4p };
  const int durations[4] = { t1t, t2t, t3t, t4t };

  profilePointCount = 0;
  profilePoints[profilePointCount++] = { 0.0f, (float)pressures[0], false };

  float elapsed = 0.0f;
  for (int i = 0; i < 4; i++)
  {
    elapsed += (float)durations[i];
    // The pressure of the *next* step starts where this one ends; the last
    // step holds its own pressure to the end of the profile.
    float bar = (float)((i < 3) ? pressures[i + 1] : pressures[3]);
    profilePoints[profilePointCount++] = { elapsed, bar, true };
  }
}

// Cheap fingerprint of the polyline, used to notice that a different profile
// was loaded — or a manual value edited — while the brew page is open. Times
// and pressures are folded in at their 0.1 resolution.
uint32_t profileSegmentSignature()
{
  uint32_t signature = (uint32_t)profilePointCount;
  for (int i = 0; i < profilePointCount; i++)
  {
    signature = signature * 31u + (uint32_t)(profilePoints[i].seconds * 10.0f);
    signature = signature * 31u + (uint32_t)(profilePoints[i].bar * 10.0f);
    signature = signature * 31u + (profilePoints[i].jump ? 1u : 0u);
  }
  return signature;
}

// Pressure (bar) to a waveform sample on the brew page's 0..10 bar scale.
int pressureToWave(float bar)
{
  int wave = (int)((bar / 10.0f) * BREW_WAVEFORM_HEIGHT + 0.5f);
  return constrain(wave, 0, BREW_WAVEFORM_HEIGHT);
}

// Writes the target-pressure bar only when the sample actually changes. With
// ramped profiles the target moves continuously, and pressureProfile() runs on
// every loop iteration — writing it unconditionally would flood UART2 during a
// shot, which is the one time the loop must stay quick.
void writeSetBarValue(int wave)
{
  static int lastWave = -1;
  if (wave == lastWave)
  {
    return;
  }
  lastWave = wave;
  myNex.writeNum("setbar.val", wave);
}

// Draws the whole target curve of the active profile into the brew page's
// waveform, so the shape of the shot is visible before the lever is pulled.
// The profile is spread across the full width of the graph, so the preview
// always fills it regardless of how long the profile runs.
//
// Two details make this work:
//   * The HMI's own timers (`waveTimer`, `tm0`) call `add` on the waveform
//     whenever the brew page is loaded, which would scroll the preview off
//     within seconds. They are stopped here and started again by brewDetect()
//     when a shot begins, which is the only time the live trace is wanted.
//   * The samples go out with `addt` (transparent data mode), one byte each.
//     350 individual `add` commands would be ~4.9 kB of UART traffic and would
//     block the loop — and therefore brew detection — for close to half a
//     second.
bool drawTargetProfilePreview()
{
  // Freeze the live plotters so the preview stays put.
  sendNextionCommand("waveTimer.en=0");
  sendNextionCommand("tm0.en=0");
  sendNextionCommand("cle " + String(BREW_WAVEFORM_ID) + ",255");

  float totalSeconds = profileTotalSeconds();
  if (!pressureProfilingEnabled || totalSeconds <= 0.0f)
  {
    // Nothing configured to show — an empty graph is the honest answer.
    return true;
  }

  static uint8_t points[BREW_WAVEFORM_WIDTH];
  for (int i = 0; i < BREW_WAVEFORM_WIDTH; i++)
  {
    float second = ((float)i * totalSeconds) / (float)(BREW_WAVEFORM_WIDTH - 1);
    points[i] = (uint8_t)pressureToWave(profileTargetPressureAt(second));
  }

  sendNextionCommand("addt " + String(BREW_WAVEFORM_ID) + "," +
                     String(BREW_WAVEFORM_TARGET_CHANNEL) + "," +
                     String(BREW_WAVEFORM_WIDTH));

  if (!nextionWaitForStatus(0xFE, NEXTION_ADDT_READY_TIMEOUT_MS))
  {
    Serial.println("[DISPLAY] Profile preview: display never signalled ready for addt");
    return false;
  }

  Serial2.write(points, BREW_WAVEFORM_WIDTH);

  if (!nextionWaitForStatus(0xFD, NEXTION_ADDT_DONE_TIMEOUT_MS))
  {
    Serial.println("[DISPLAY] Profile preview: display did not confirm the addt transfer");
    return false;
  }

  Serial.print("[DISPLAY] Profile preview drawn: "); Serial.print(activeProfileName);
  Serial.print(" over "); Serial.print(totalSeconds, 1); Serial.print("s, ");
  Serial.print(profilePointCount); Serial.println(" points");
  return true;
}

void pressureProfile()
{
  if (brewActive && pressureProfilingEnabled)
  {
    // Brew-by-weight auto-stop is only valid when a scale is connected and
    // we have received at least one weight sample in this session.
    bool brewByWeightActive =
        scaleConnected &&
        targetWeight > 0.0f &&
        lastWeightTime > 0;

    // Target-weight latch: once the cut-off weight has been reached, keep the
    // pump off for the rest of this brew. Without this latch the pressure drop
    // after the pump stops would shrink the offset again, and the profile
    // segments below would switch the pump back on.
    if (targetWeightReached)
    {
      setPumpBrightness(0);
      return;
    }

    if (brewByWeightActive)
    {
      float pressureNow = getPressure();
      if (currentWeight >= targetWeight - weightStopOffset(pressureNow))
      {
        // Start stability window from the exact moment target stop is triggered.
        if (!pendingObservation)
        {
          startPendingObservation(flowRate, pressureNow);
        }
        targetWeightReached = true;
        setPumpBrightness(0);
        writeBrewTimerColour(1535);
        writeSetBarValue(0);
        return;
      }
    }

    // Safety: a profile with no duration is not configured. Skip profiling so
    // the pump is not silently killed. This is checked after the weight cut-off
    // above so brew-by-weight still stops the shot when no profile is loaded.
    float totalProfileSeconds = profileTotalSeconds();
    if (totalProfileSeconds <= 0.0f)
    {
      setPumpBrightness(255);  // No profile configured → full power
      return;
    }

    float brewSecs = (millis() - activeBrewingStart) / 1000.0f;

    // profileTargetPressureAt() holds the last point's pressure once the
    // profile has run out, letting the weight cut-off above — or the lever —
    // end the shot. Cutting the pump here would end a brew-by-weight shot short
    // of its target whenever the profile is shorter than the shot takes.
    float target = profileTargetPressureAt(brewSecs);
    writeSetBarValue(pressureToWave(target));
    setPressure(target);

    if (brewSecs > totalProfileSeconds)
    {
      writeBrewTimerColour(1535);
    }
    else if (totalProfileSeconds - brewSecs <= 3.0f)
    {
      writeBrewTimerColour(64864);
    }
  }
}

// Recolours the brew timer, skipping the write when the colour is unchanged —
// this runs on every loop iteration during a shot.
void writeBrewTimerColour(uint32_t colour)
{
  static uint32_t lastColour = 0xFFFFFFFFu;
  if (colour == lastColour)
  {
    return;
  }
  lastColour = colour;
  myNex.writeNum("n0.pco", colour);
  myNex.writeNum("n1.pco", colour);
}

// Writes the brew button picture only when it actually changes. Sending it on
// every idle loop iteration flooded UART2 for no benefit.
void writeBrewButtonPicture(int picture)
{
  static int lastBrewButtonPicture = -1;
  if (picture == lastBrewButtonPicture)
  {
    return;
  }
  lastBrewButtonPicture = picture;
  myNex.writeNum("pBrew.pic", picture);
}

void brewDetect()
{
  if (brewState())
  {
    if (cleaningModeActive && !cleaningRunActive)
    {
      myNex.writeNum("cleanTimer", 1);
      cleaningRunActive = true;
      cleaningShots++;
      if (cleaningShots < 6)
      {
        myNex.writeNum("n0.val", cleaningShots);
        if (cleaningShots == 5)
        {
          myNex.writeNum("n0.pco", 2047);
        }
      }
      else
      {
        myNex.writeNum("n0.pco", 65535);
        cleaningShotsWater++;
        myNex.writeNum("n0.val", cleaningShotsWater);
        if (cleaningShotsWater == 5)
        {
          myNex.writeNum("n0.pco", 2047);
        }
      }
    }

    if (!brewActive && !cleaningModeActive)
    {
      myNex.writeStr("page brew");
      delay(10);

      // Wipe the target-curve preview and hand the waveform back to the HMI's
      // own plotters, which drawTargetProfilePreview() had stopped.
      sendNextionCommand("cle " + String(BREW_WAVEFORM_ID) + ",255");
      sendNextionCommand("waveTimer.en=1");
      sendNextionCommand("tm0.en=1");
      brewPreviewNeedsDraw = false;

      brewTimer(true);
      writeBrewButtonPicture(25);
      brewActive = true;
      targetWeightReached = false;  // Fresh brew — clear the weight cut-off latch

      // Seed dimmer debug counters so the first ZC/s reading is not
      // inflated by zero-crossings accumulated since boot.
      lastZeroCrossCountDebug = zeroCrossCount;
      lastDimmerDebugMs = millis();

      // Enable TRIAC at full power; pressureProfile() adjusts immediately if profiling is enabled
      setPumpBrightness(255);
    }
  }
  else
  {
    bool wasBrewing = brewActive;
    brewActive = false;
    brewTimer(false);
    writeBrewButtonPicture(8);

    // Only hand the dimmer back to idle control on the brew→idle edge.
    // Doing this every idle loop fought updateIdlePumpControl() (255↔0
    // chatter) and reset boilerFullLatch before it could ever hold.
    if (wasBrewing)
    {
      targetWeightReached = false;  // Clear weight cut-off latch for next brew
      resumeIdleBoilerFill();       // Unlock idle control and hand full pump control back to GiCar
    }

    if (cleaningRunActive)
    {
      myNex.writeNum("cleanTimer", 0);
    }
    cleaningRunActive = false;
  }
}

bool brewState()
{
  bool brewOn = readDebouncedBrewSwitchOn();
  writeBrewRelay(brewOn);  // Signal GiCar: brew switch state
  return brewOn;
}

bool readRawBrewSwitchOn()
{
#if BREW_SWITCH_ACTIVE_LOW
  return digitalRead(BREW_SWITCH_PIN) == LOW;
#else
  return digitalRead(BREW_SWITCH_PIN) == HIGH;
#endif
}

bool readDebouncedBrewSwitchOn()
{
  bool rawOn = readRawBrewSwitchOn();
  unsigned long now = millis();

  if (!brewSwitchDebounceInitialized)
  {
    brewSwitchDebounceInitialized = true;
    brewSwitchLastRawOn = rawOn;
    brewSwitchStableOn = rawOn;
    brewSwitchLastChangeMs = now;
    return brewSwitchStableOn;
  }

  if (rawOn != brewSwitchLastRawOn)
  {
    brewSwitchLastRawOn = rawOn;
    brewSwitchLastChangeMs = now;
  }

  if ((now - brewSwitchLastChangeMs) >= BREW_SWITCH_DEBOUNCE_MS &&
      brewSwitchStableOn != rawOn)
  {
    brewSwitchStableOn = rawOn;
    Serial.print("[BREW] Lever ");
    Serial.println(brewSwitchStableOn ? "ON" : "OFF");
  }

  return brewSwitchStableOn;
}

void writeBrewRelay(bool brewOn)
{
#if BREW_RELAY_ACTIVE_HIGH
  digitalWrite(BREW_RELAY_PIN, brewOn ? HIGH : LOW);
#else
  digitalWrite(BREW_RELAY_PIN, brewOn ? LOW : HIGH);
#endif
}

// Mara X Machine Input Parser
// Frame format (CSV): +1.10,023,,0,022,0000,0,0
// Terminated with CR (\r)
void getMaschineInput()
{
  static unsigned long lastFrameReceivedMs = 0;
  bool newFrameThisIteration = false;
  
  while (Serial1.available())
  {
    rc = Serial1.read();

    // Uncomment for raw byte debugging (disabled by default - confirmed working)
    // Serial.print("[RAW] 0x");
    // if ((uint8_t)rc < 0x10) Serial.print("0");
    // Serial.print((uint8_t)rc, HEX);
    // Serial.print(" (");
    // if (rc >= 0x20 && rc < 0x7F) Serial.print(rc); else Serial.print('?');
    // Serial.println(")");
    
    if (rc != endMarker)
    {
      receivedCharsFromMarax[ndx] = rc;
      ndx++;
      if (ndx >= numCharsSerialMarax)
      {
        ndx = numCharsSerialMarax - 1;
      }
    }
    else
    {
      receivedCharsFromMarax[ndx] = '\0';
      ndx = 0;
      newFrameThisIteration = true;
      lastFrameReceivedMs = millis();
      
      // Only log frame if it contains new/changed data (not every poll)
      static int lastBrewTemp = -1;
      static int lastSteamTemp = -1;
      bool tempChanged = false;

      // Parse CSV format: +1.10,103,128,077,0000,1,0
      // Manual split to handle empty fields correctly (strtok skips them)
      // Field 0: Version (+1.10)
      // Field 1: Steam temp (103 = 103°C)
      // Field 2: Steam target temp (128°C, or empty)
      // Field 3: Brew temp (077 = 77°C)
      // Field 4: Fast heat countdown (0000)
      // Field 5: Heating element (1 = on)
      // Field 6: Unknown
      
      char parseBuffer[numCharsSerialMarax];
      strncpy(parseBuffer, receivedCharsFromMarax, sizeof(parseBuffer));
      
      char* fields[8];
      int fieldCount = 0;
      char* start = parseBuffer;
      
      // Split by commas, preserving empty fields
      for (int i = 0; parseBuffer[i] != '\0' && fieldCount < 8; i++)
      {
        if (parseBuffer[i] == ',')
        {
          parseBuffer[i] = '\0';
          fields[fieldCount++] = start;
          start = &parseBuffer[i + 1];
        }
      }
      if (fieldCount < 8)
      {
        fields[fieldCount++] = start;  // Last field
      }
      
      // Parse fields
      // field[1]=steam temp  field[2]=steam target  field[3]=brew temp
      // field[4]=countdown   field[5]=heating
      if (fieldCount > 3 && fields[3][0] != '\0')
      {
        int newBrewTemp = atoi(fields[3]);
        if (newBrewTemp != lastBrewTemp)
        {
          tempChanged = true;
          lastBrewTemp = newBrewTemp;
        }
        brewTemp = newBrewTemp;
      }
      if (fieldCount > 2 && fields[2][0] != '\0')
      {
        steamTargetTemp = atoi(fields[2]);
      }
      if (fieldCount > 1 && fields[1][0] != '\0')
      {
        int newSteamTemp = atoi(fields[1]);
        if (newSteamTemp != lastSteamTemp)
        {
          tempChanged = true;
          lastSteamTemp = newSteamTemp;
        }
        steamTemp = newSteamTemp;
      }
      if (fieldCount > 4 && fields[4][0] != '\0')
      {
        fastHeatingCountDown = atoi(fields[4]);
      }
      if (fieldCount > 5 && fields[5][0] != '\0')
      {
        heatingElementOn = atoi(fields[5]);
      }
      
      // Only log when temps actually change
      if (tempChanged)
      {
        Serial.print("[DEBUG] Machine frame: ");
        Serial.println(receivedCharsFromMarax);
        Serial.print("[DEBUG] Temps - brew:"); Serial.print(brewTemp);
        Serial.print("°C steam:"); Serial.print(steamTemp);
        Serial.print("°C target:"); Serial.print(steamTargetTemp);
        Serial.print("°C heating:"); Serial.println(heatingElementOn ? "ON" : "OFF");
      }
    }
  }
  
  // Check for machine power state based on fresh data and timeout
  if (newFrameThisIteration)
  {
    if (!POWER_ON)
    {
      primePressureFilter();
      resumeIdleBoilerFill();
      Serial.println("[DEBUG] POWER_ON = true (machine data received)");
    }
    POWER_ON = true;
  }
  else if (POWER_ON && lastFrameReceivedMs > 0 && (millis() - lastFrameReceivedMs > 15000))
  {
    Serial.println("[DEBUG] POWER_ON = false (no serial for 15 seconds)");
    POWER_ON = false;
    brewTemp = 0;
    steamTemp = 0;
    steamTargetTemp = 0;
    fastHeatingCountDown = 0;
    heatingElementOn = 0;

#ifndef DISABLE_WIFI_MQTT
    if (mqttClient.connected())
    {
      mqttClient.publish(brewtemp_topic, toCharArray(String(brewTemp)), true);
      mqttClient.publish(steamtemp_topic, toCharArray(String(steamTemp)), true);
      mqttClient.publish(steamtargettemp_topic, toCharArray(String(steamTargetTemp)), true);
      mqttClient.publish(fastheat_topic, toCharArray(String(fastHeatingCountDown)), true);
      mqttClient.publish(heatingElement_topic, toCharArray(String(heatingElementOn)), true);
      mqttClient.publish(shots_topic, toCharArray(String(shotCount)), true);
      mqttClient.publish(power_topic, toCharArray(String(POWER_ON)), true);
    }
#endif
  }

  if (millis() - serialMaraxUpdateMillis > 5000)
  {
    serialMaraxUpdateMillis = millis();
    memset(receivedCharsFromMarax, 0, numCharsSerialMarax);
    ndx = 0;
    
    // Reduced logging - only every 30 seconds (machine communication confirmed working)
    static unsigned long lastPollDebugMs = 0;
    if (millis() - lastPollDebugMs > 30000)
    {
      Serial.println("[DEBUG] Polling machine...");
      lastPollDebugMs = millis();
    }
    
    Serial1.write(0x11);
  }
}

void brewTimer(bool start)
{
  if (!brewTimerActive && start)
  {
    myNex.writeNum("activeBrewTime", 0);
    myNex.writeNum("timerState", 1);
    activeBrewingStart = millis();
    brewTimerActive = true;
  }
  else if (!start)
  {
    if (brewTimerActive)
    {
      myNex.writeNum("timerState", 0);
      int brewSecs = (int)((millis() - activeBrewingStart) / 1000);
      if (brewSecs > 20)
      {
        shotCount++;
      }

      float weightAtStop = currentWeight;
      float flowAtStop = flowRate;
      float pressAtStop = getPressure();

      // If target-weight stop already started pending observation, keep its
      // start time so the stability window reflects pump-off timing.
      if (pendingObservation)
      {
        pendingBrewTimeS = brewSecs;
      }
      else if (scaleConnected && lastWeightTime > 0)
      {
        startPendingObservation(flowAtStop, pressAtStop);
        pendingWeightAtStop = weightAtStop;
        pendingBrewTimeS = brewSecs;
      }
      else
      {
        pendingObservation = false;
      }
    }
    brewTimerActive = false;
  }
}
