laurentflorin/marax-pressure-mod/(commit log)

2026-05-19 feat: add SD profiles BLE scale and OLS prediction
    Agent-Logs-Url: https://github.com/laurentflorin/marax-pressure-mod/sessions/270dc12b-f623-4dea-8b4c-91642de8b053
    [default.csv]
2026-05-19 chore: refine new profile and OLS constants
    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
2026-05-19 chore: dedupe OLS default constants
    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
2026-05-19 chore: polish validation nits
    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
2026-05-19 feat: add five example pressure profiles
    Agent-Logs-Url: https://github.com/laurentflorin/marax-pressure-mod/sessions/7a7b2dc8-63e6-4989-913b-b31845328ca2
    [blooming_espresso.csv, classic_espresso.csv, declining_pressure.csv, pre_infusion_ramp.csv, turbo_espresso.csv]
2026-05-19 Use weight stability window instead of fixed settling delay
    Agent-Logs-Url: https://github.com/laurentflorin/marax-pressure-mod/sessions/1296c5dc-4e69-4d48-8e62-e24c16f12fce
2026-05-19 Update print statement from 'Hello' to 'Goodbye'
2026-05-20 Add manual Nextion pressure profile fallback mode
    Agent-Logs-Url: https://github.com/laurentflorin/marax-pressure-mod/sessions/0b80b5f7-6b6d-4c3d-befb-17a27a747674
2026-05-20 refactor: replace two-pass loadObservations with single-pass ring buffer
    Agent-Logs-Url: https://github.com/laurentflorin/marax-pressure-mod/sessions/22359f09-9e55-4368-98df-2fe15d59faec
2026-05-21 Update for new pressure sensor
    Updated pressure calculation logic and improved comments for clarity.
2026-06-02 Revise README for LELIT MaraX Pressure Mod
    Updated README to reflect new features and project details.
2026-06-09 Add slayer_shot profile to CSV
    [slayer_shot.csv]
2026-06-10 Expand OLS model with interaction and squared pressure terms
2026-06-10 wiring diagram png
2026-06-13 move to esp32 and add debug
2026-06-25 Add NimBLE-based implementation for Felicita Arc scale
    - Introduced FelicitaScale_NimBLE class for managing BLE communication with the Felicita Arc scale.
    - Implemented methods for connecting, receiving weight data, and sending commands (tare, start/stop/reset timer).
    - Added parsing logic for weight notifications and battery level.
    - Included debug logging for connection status and data received.
    - Defined UUIDs for the Felicita service and characteristic.
    [blooming_espresso.csv, classic_espresso.csv, declining_pressure.csv, turbo_espresso.csv]
2026-06-25 Remove outdated Linux upload permissions documentation for ESP32-S3 board
2026-06-25 Update build documentation and add new asset images for wiring and components
2026-07-07 Refactor profile selection to Nextion popup list and persist startup profile state
    Agent-Logs-Url: https://github.com/laurentflorin/marax-pressure-mod/sessions/0fe245d7-6ce2-415b-83b2-161218a3f7fc
2026-07-07 Refactor Nextion profile selection to touch-list workflow and persist target weight/profile state across reboot
    Agent-Logs-Url: https://github.com/laurentflorin/marax-pressure-mod/sessions/acecd830-c9a8-4051-8e9a-d6b46ed447ac
    [marax_esp32s3.ino]
2026-07-07 Refactor Nextion profile selection to row-based popup flow and persist profile/target-weight state
    Agent-Logs-Url: https://github.com/laurentflorin/marax-pressure-mod/sessions/3975fdd5-ea37-4ab0-9bc0-2f41e463aca8
2026-07-19 brew by weight only active if scale connected, this ensures pressure profilking is possible if scale is not connected
2026-07-20 revert changes to pressure profiling
    [marax_esp32s3.ino]
2026-07-23 ensuring pump runs on start up to fill boiler
2026-07-24 fixing bug boiler not filling up at start up
    [marax_esp32s3.ino]
2026-08-22 feat: replace the four fixed profile steps with an anchor polyline
    A profile is now a list of points, each anchoring a target pressure at an
    absolute time from the start of the shot, with a per-point flag choosing how
    the curve reaches it: ramp linearly from the previous point, or hold the
    previous pressure and jump at this point's time. That covers the old staircase
    (every point a jump), a smooth declining curve (every point a ramp), and
    mixtures of the two — hold 3 bar, jump to 8, hold, then ramp down to 6.
    pressureProfile() now interpolates on every loop iteration instead of walking
    an if/else chain once a second, so ramps are actually smooth. Because the
    target moves continuously, the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
    [marax_esp32s3.ino]
2026-08-22 feat: add a drag-the-curve profile editor for Home Assistant
    A self-contained Lovelace card — no HACS, no build step, no dependencies. It
    subscribes to the profile topics over Home Assistant's websocket MQTT API,
    renders the profile as an SVG curve, and lets you drag the points, add and
    remove them, and switch each between ramp and jump. Save publishes the v2 CSV
    back to the controller, which validates it and writes it to the SD card.
    The card renders the curve as a polyline while the firmware interpolates, so
    the two could easily drift and the graph would then be a lie about what the
    pump does. A cross-check test compiles the firmware's profileTargetPressureAt()
    for the host and compares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
    [mixed_ramp_jump.csv]
2026-08-22 docs: add a ready-made Home Assistant dashboard
    Three views for the raw configuration editor: the machine's live state, the
    profile editor, and a diagnostics page.
    The Machine view leads with two conditional banners, because "no reading" has
    two quite different causes on this setup and they deserve different answers:
    the controller being offline, which takes every entity unavailable through the
    MQTT last will, and the machine simply being switched off, which takes only the
    power-gated temperatures unavailable so they cannot drag the history graph down
    to 0 °C.
    Only the Profile view needs the custom card. It also carries a plain select
    tile for the active profile, so the machine can still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
2026-08-22 fix: declare the profile command queue after the macro it depends on
    PendingProfileCommand sizes its members with PROFILE_NAME_MAX_LEN but sat
    above the profile globals that define it. The preprocessor left the array
    member out, so the struct had no `stem` at all and every use of it failed —
    along with its initialiser, which then had too many values for the members
    that survived. Moved the block below the define.
    Adds test/compile, which syntax-checks the sketch with the real xtensa
    toolchain using the include and define set Arduino IDE uses for the ESP32S3
    Dev Module, reusing whatever the IDE already downloaded and skipping if it is
    not installed. The host suites test the profile maths a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
    [marax_esp32s3.ino]
2026-08-22 fix: show the newly selected profile in the card straight away
    Switching profiles while holding unsaved edits left the previous profile on
    screen until Revert was pressed. The guard that kept local edits was too
    broad: it refused every incoming profile whenever the screen was dirty, which
    is right for the controller repeating itself but wrong once it has genuinely
    loaded something else.
    The card now distinguishes the two. A body identical to what the controller
    last sent is a repeat, and local edits survive it. A body that differs means
    the machine has moved on — a different profile selected, or the file changed
    elsewhere — and the screen follows, saying in the status line that unsaved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
