laurentflorin/marax-pressure-mod/assets/Relay_dimmer.jpg

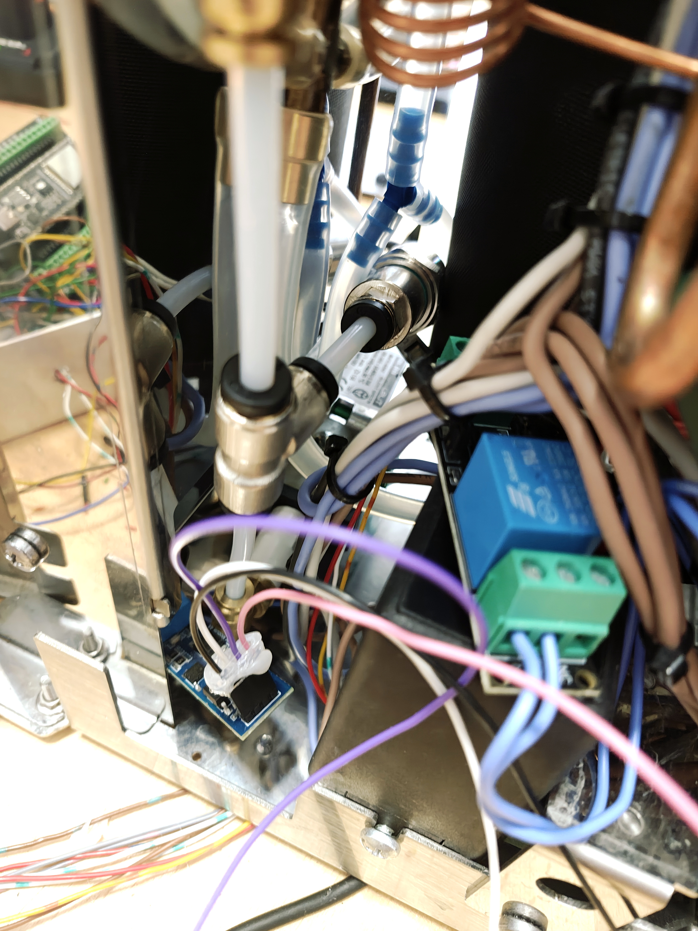
assets/Relay_dimmer.jpg
